kurdish-yoda/TOS/PCB/README.md

# TonsOfSteppers

Stepper Driver Board


## Description
This is an stepper driver board that can drive up to 15 steppers simultaneously,
and up to 8 synchronously. A raspberry is used to control everything. 

## Features
- 8V to 40V input with protection
- 15x stepper pinout.
- Up to 10A capability. 

## Software
All software is written in python. To be used with an RasperryPi with a standart 40pin GPIO.

## Pictures
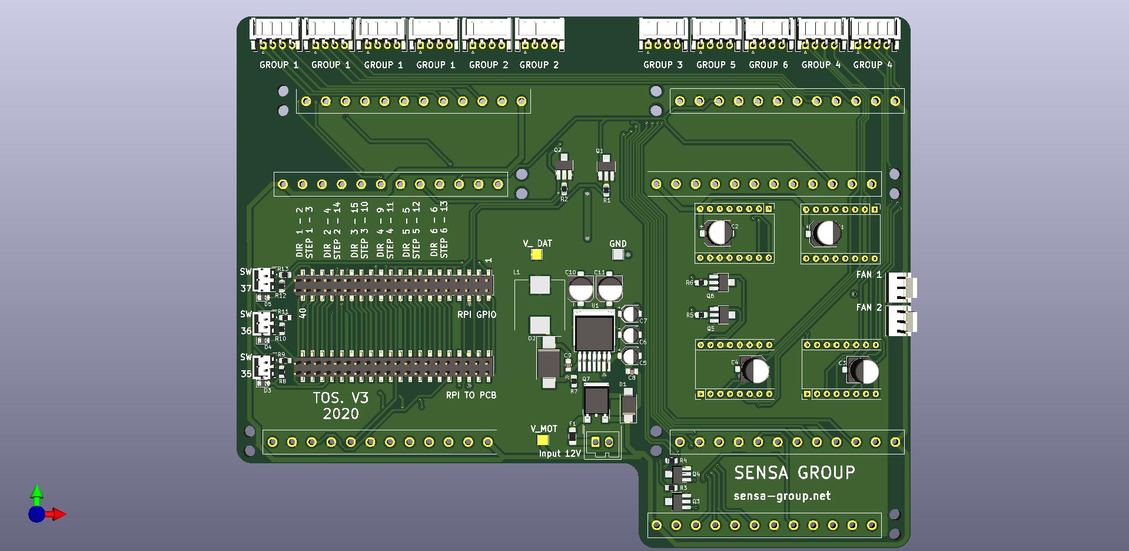
[picture p1: Images/TonOfSteppers.jpg]
Top_view

Bottom_view
