kurdish-yoda/TOS/Code_and_Documents/price.png

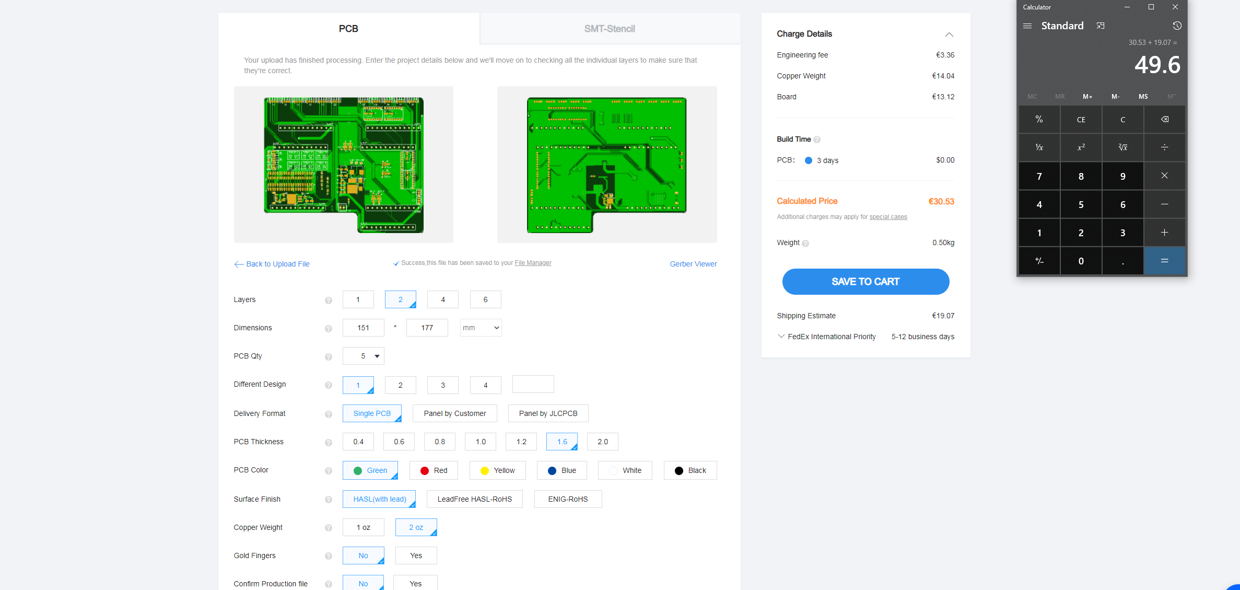
Code_and_Documents/price.png
