kurdish-yoda/TOS/Images/case1.jpeg

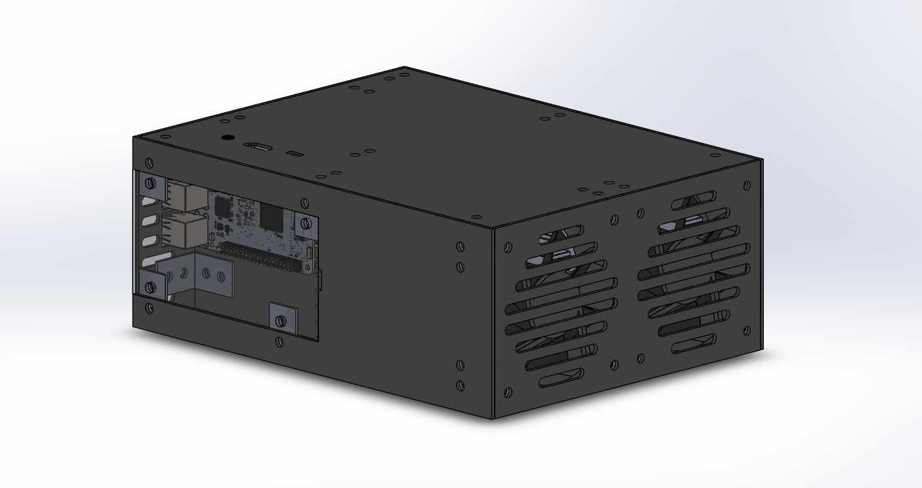
Images/case1.jpeg
