kurdish-yoda/TOS/Code_and_Documents/BOM.xlsx

Electronic Component | Manufacture | Pieces | Footprint Asignment | Datasheet
95157-440LF | AMPHENOL ICC | 4 | J1, J2 | https://export.farnell.com/amphenol-icc/95157-440lf/board-to-board-header-40-position/dp/1924218
LM2678SX-5.0/NOPB | Texas Instruments | 2 | U1 | https://www.ti.com/lit/ds/symlink/lm2678.pdf?HQS=dis-dk-null-digikeymode-dsf-pf-null-wwe&ts=1613410963551
Lestvica 8 pin - Zenski (2.54) | // | 16 | A1, A2, A3, A4 | //
CAP EL 100UF | Würth Elektronik | 8 | C1, C2, C3, C4 | https://www.we-online.de/katalog/datasheet/865230345005.pdf
CAP EL 15UF | Würth Elektronik | 6 | C5, C6, C7 | https://www.mouser.com/datasheet/2/445/865080340002-1726603.pdf
CAP 0.47UF | AVX Corporation | 2 | C8 | http://datasheets.avx.com/X7RDielectric.pdf
CAP 0.01UF | Murata Electronics | 2 | C9 | //
CAP EL 180UF | Panasonic | 4 | C10, C11 | https://www.mouser.com/datasheet/2/315/ABA0000C1251-1138508.pdf
CZRB5343B-HF | Comchip Technology | 2 | D1 | https://eu.mouser.com/datasheet/2/80/CZRB5338B-HF_Thru174956._CZRB5388B-HF_RevA-1481441.pdf
B560CQ-13-F | Diodes Incorporated | 2 | D2 | https://www.diodes.com/assets/Datasheets/B520CQ-B560CQ.pdf
SMD DIODE 0805 | // | 6 | D3, D4, D5 | //
TR/3216FF30-R | Bussmann / Eaton | 2 | F1 | https://www.mouser.com/datasheet/2/87/eaton-3216ff-surface-mount-fuse-data-sheet-1608666.pdf
S4B-XH-A(LF)(SN) | JST Sales America Inc. | 22 | G1, G2, G3, …, G10, G11 | https://www.jst-mfg.com/product/pdf/eng/eXH.pdf
10081121 | Molex | 14 | J3, J4, …, J9 | https://www.molex.com/pdm_docs/ps/PS-99020-0087-001.pdf
53253-0370 | Molex | 4 | J10, J31 | https://www.mouser.com/datasheet/2/276/0532530370_PCB_HEADERS-170958.pdf
B2B-PH-K-S(LF)(SN) | JST Sales America Inc. | 6 | J11, J12, J13 | https://www.jst-mfg.com/product/pdf/eng/ePH.pdf
1984617 | Phoenix Contact | 2 | J33 | https://media.digikey.com/pdf/Data%20Sheets/Phoenix%20Contact%20PDFs/Combicon%20Compact%20Series.pdf
7443551221 | Würth Elektronik | 2 | L1 | https://www.mouser.com/datasheet/2/445/7443551221-1721653.pdf
2STF1360 | STMicroelectronics | 12 | Q1, Q2, Q3, Q4, Q5, Q6 | https://www.st.com/content/ccc/resource/technical/document/datasheet/f9/7c/12/94/01/da/41/03/CD00073146.pdf/files/CD00073146.pdf/jcr:content/translations/en.C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
ATP106-TL-H | ON Semiconductor | 2 | Q7 | https://www.onsemi.com/pub/Collateral/ENA1597-D.PDF
RES 1K 0805 | // | 18 | R1, ..., R6, R8, R10, R12 | //
RES 10K 0805 | // | 8 | R7, R9, R11, R13 | //
USB-A-S-RA-TSMT | MULTICOMP | 5 | // | http://www.farnell.com/datasheets/1864222.pdf
KONEKTOR DIN 41651 40 PINA KABL. | CONNFLY electronic | 10 | // | https://www.mgelectronic.rs/konektor-din-41651-40-pina-kabldr%C5%BEa%C4%8D
7805 SMD | Texas Instruments | 2 | // | https://export.farnell.com/texas-instruments/ua7805ckttr/voltage-regulator-fixed-5v-to/dp/3122753?st=7805
