kurdish-yoda/TOS/Code_and_Documents/John Mastercode/Hc595_Solenoid_Driver.pdf

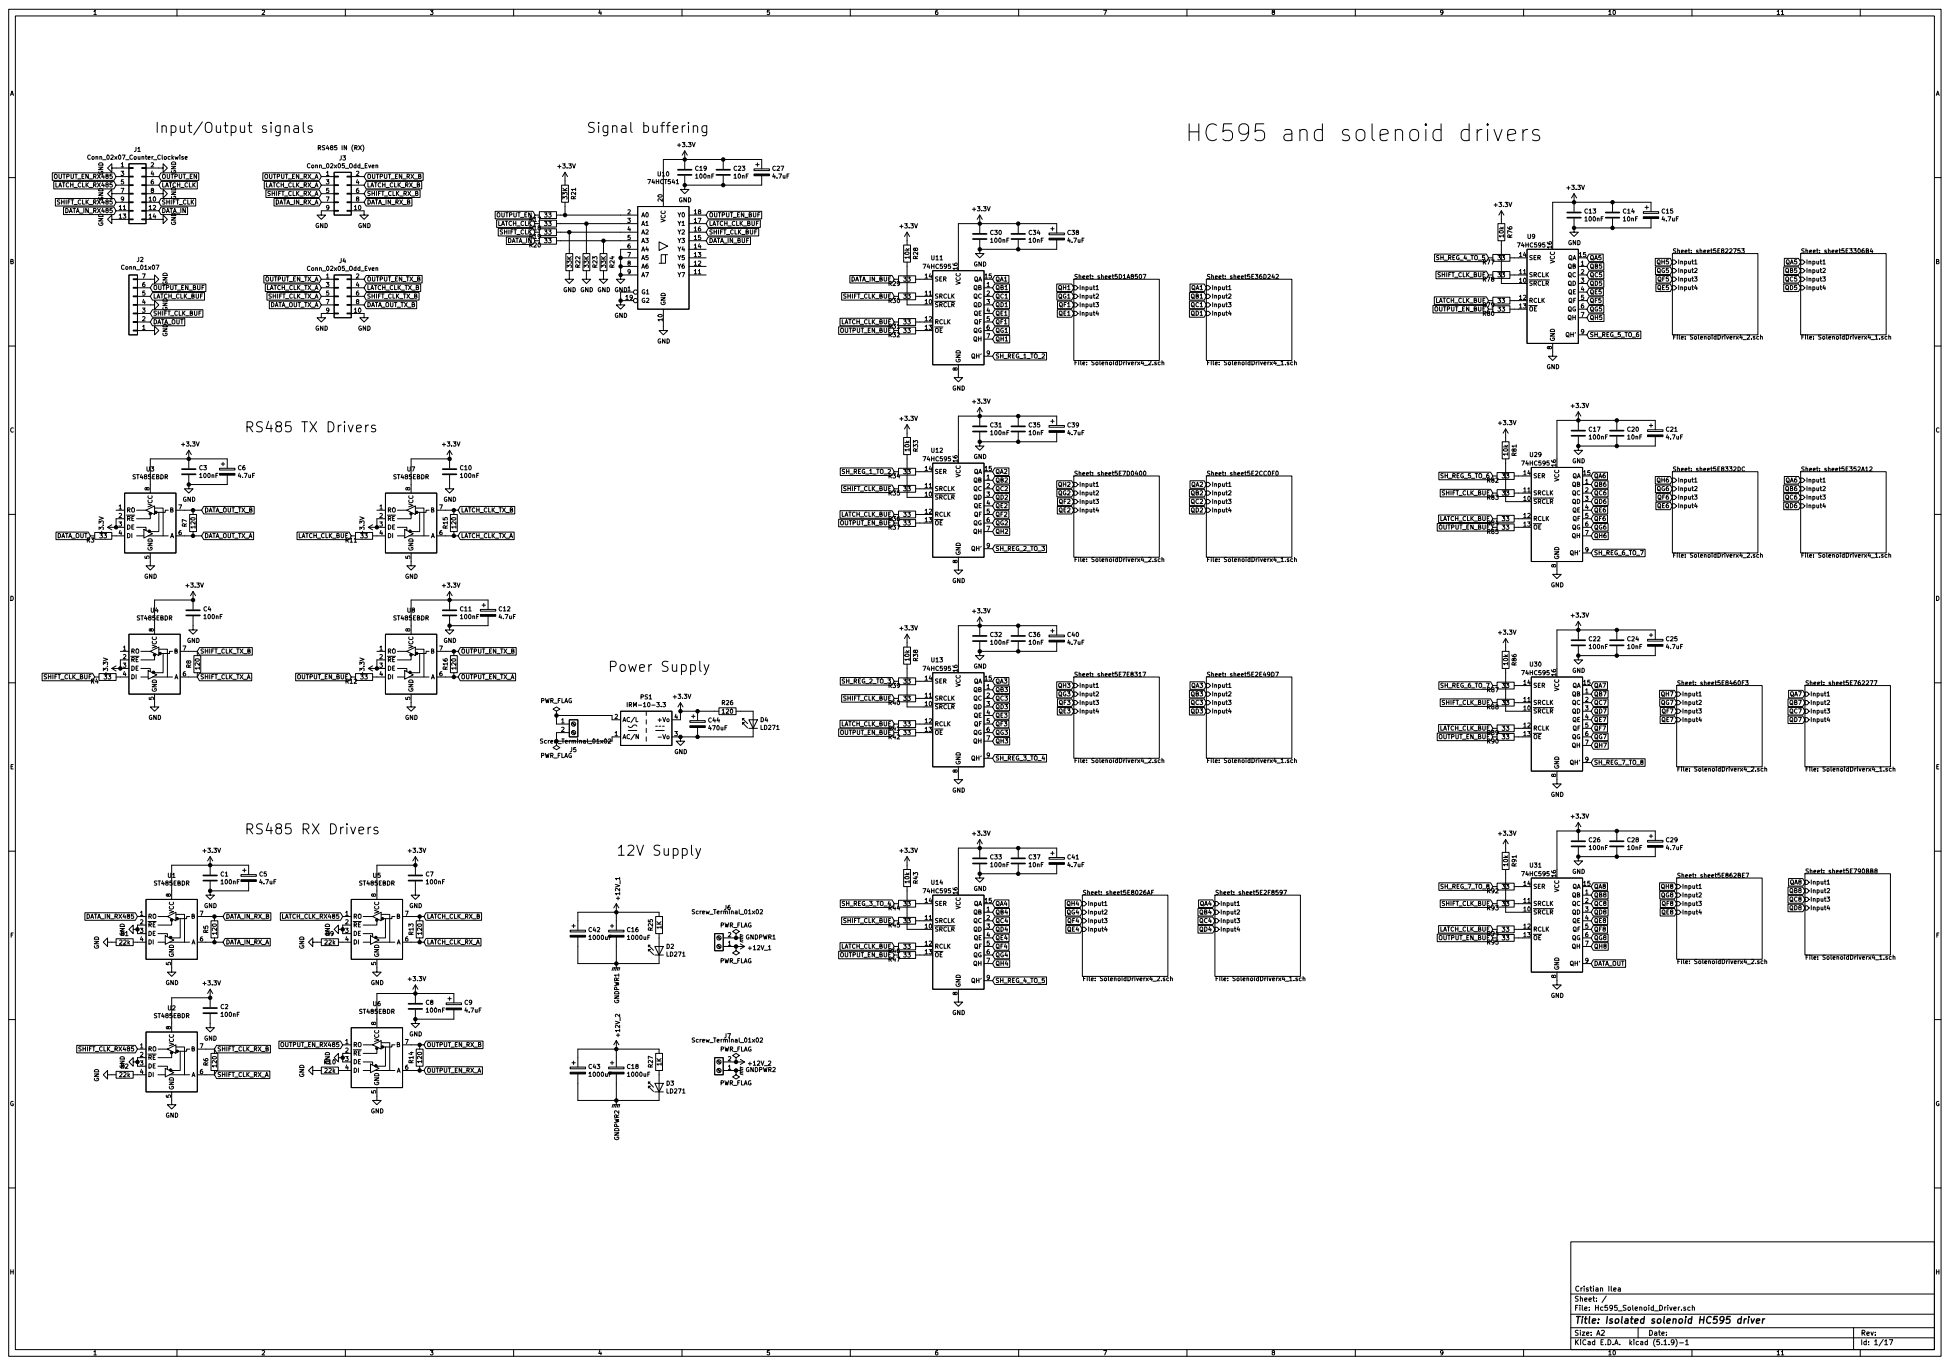
[picture p8: page 1]

8 U8 ST485EBDR R15 120 GND R7 120 RO 1 RE 2 DE 3 DI 4 GND

File: Hc595_Solenoid_Driver.sch Sheet: / Cristian Ilea

Id: 1/17 Title: Isolated solenoid HC595 driver

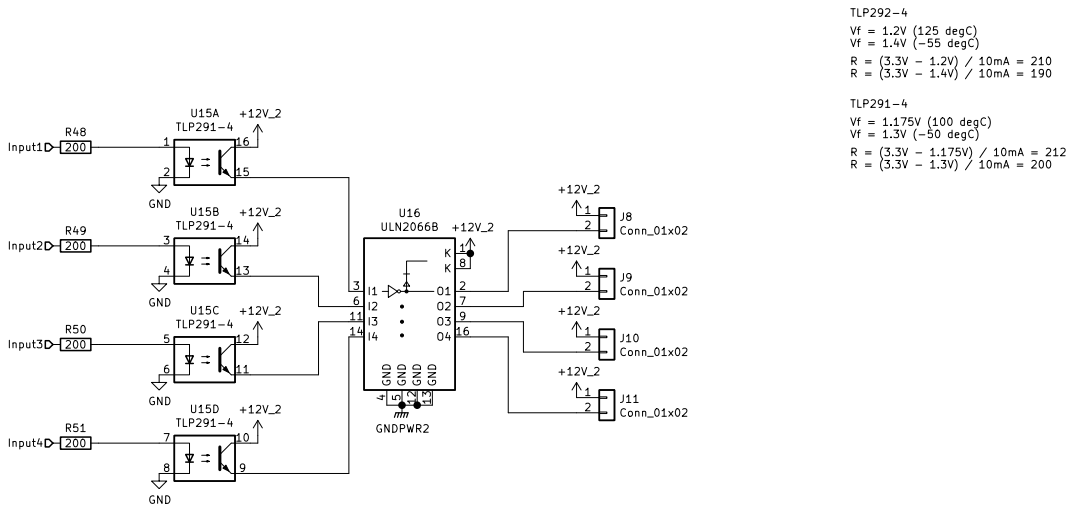
[picture p9: page 2]

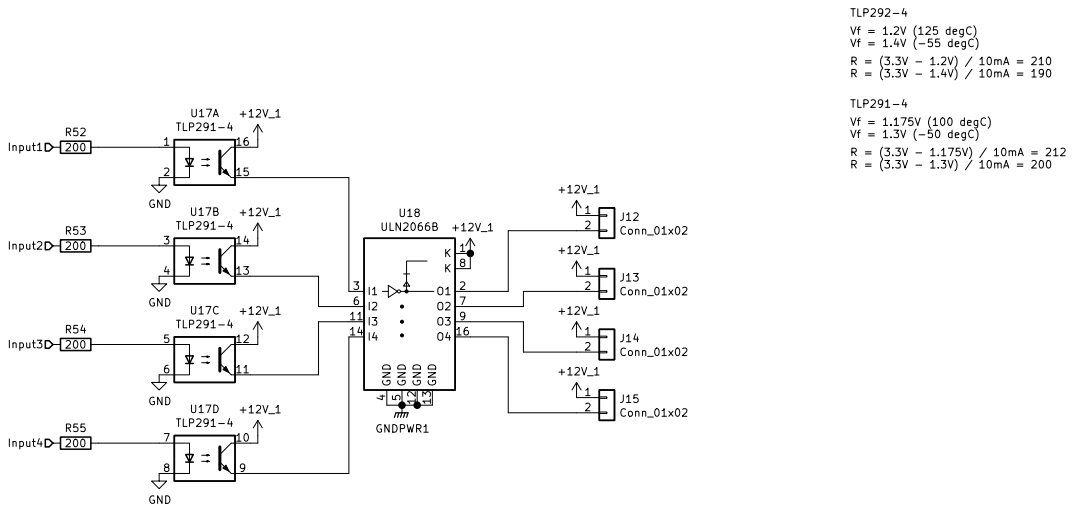
[picture p10: page 3]

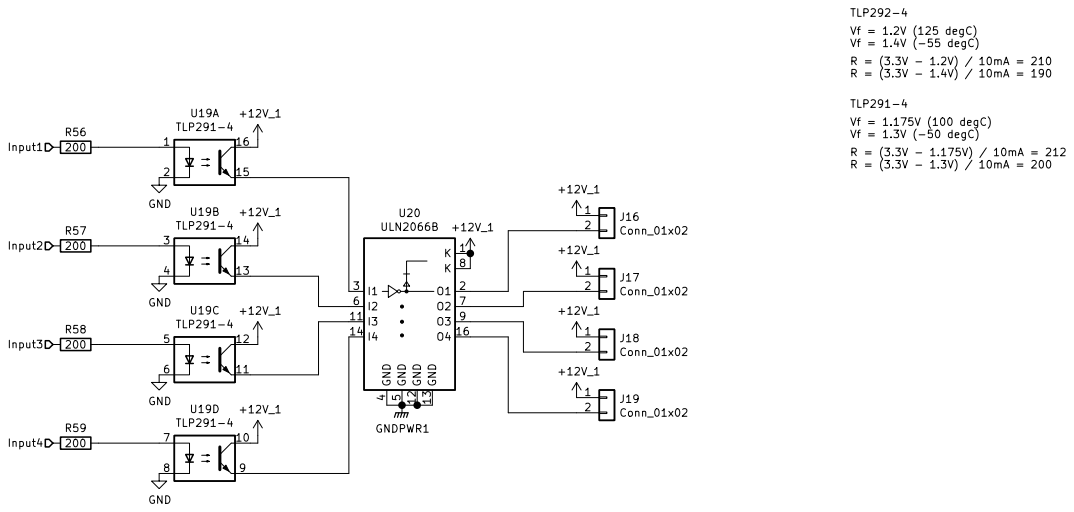
[picture p11: page 4]

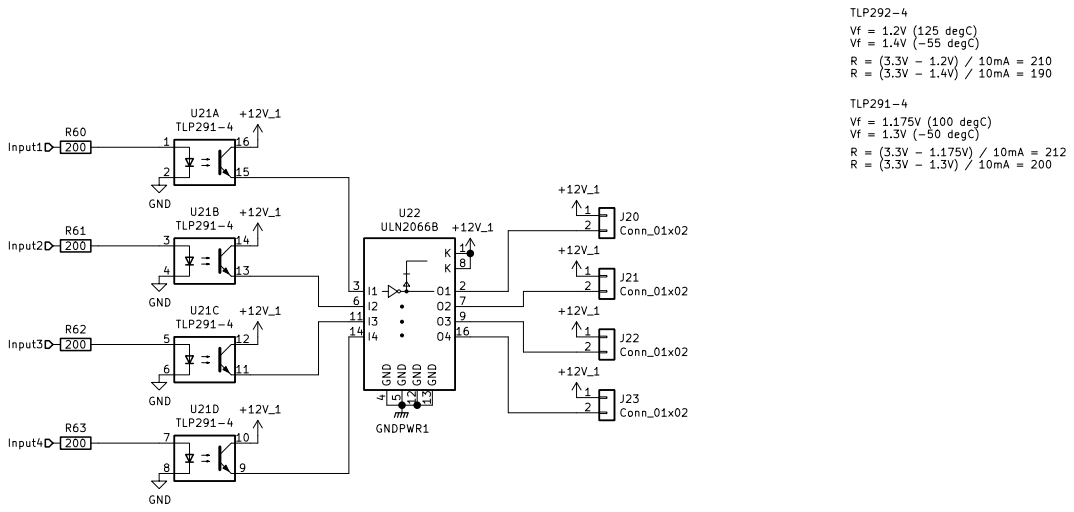
[picture p12: page 5]

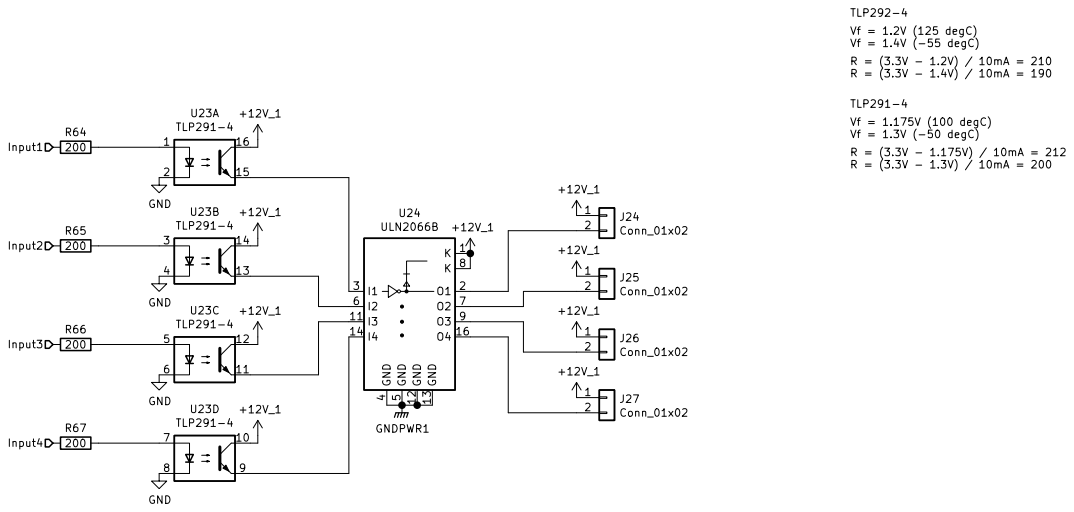
[picture p13: page 6]

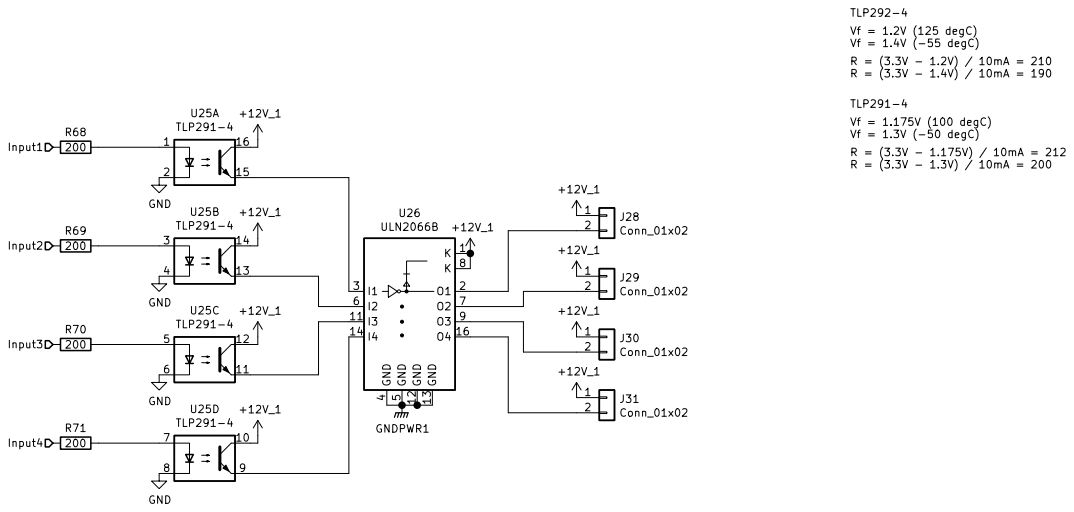
[picture p14: page 7]

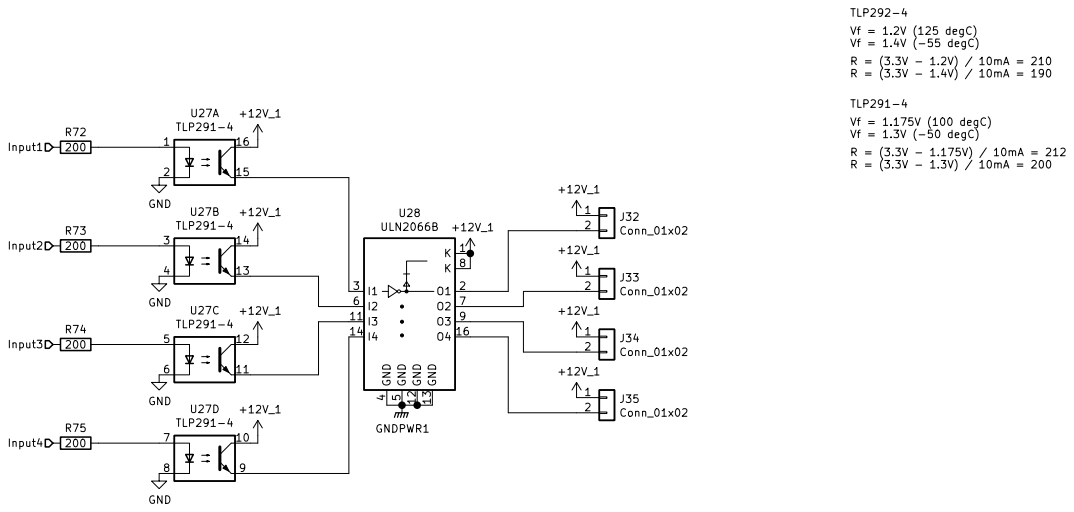
[picture p15: page 8]

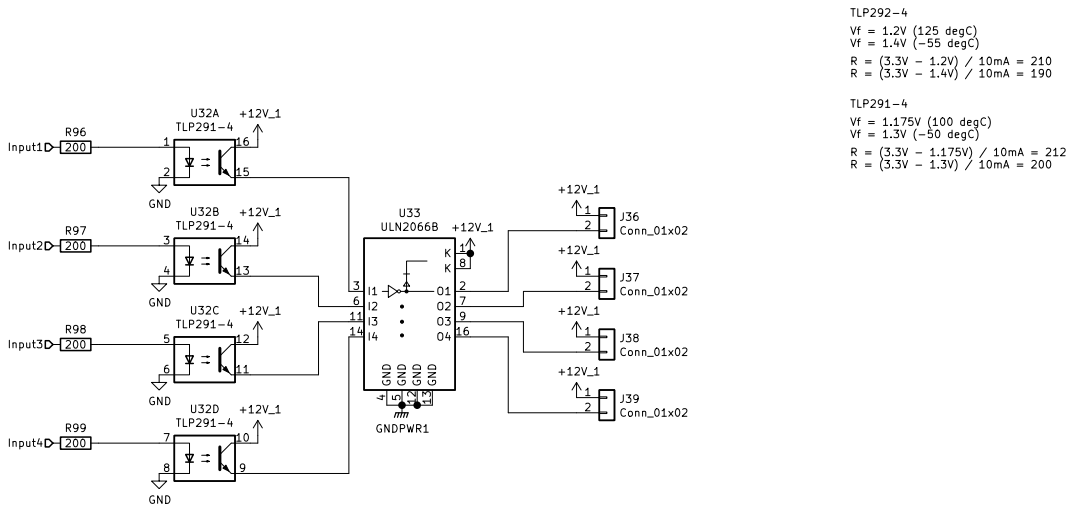
[picture p16: page 9]

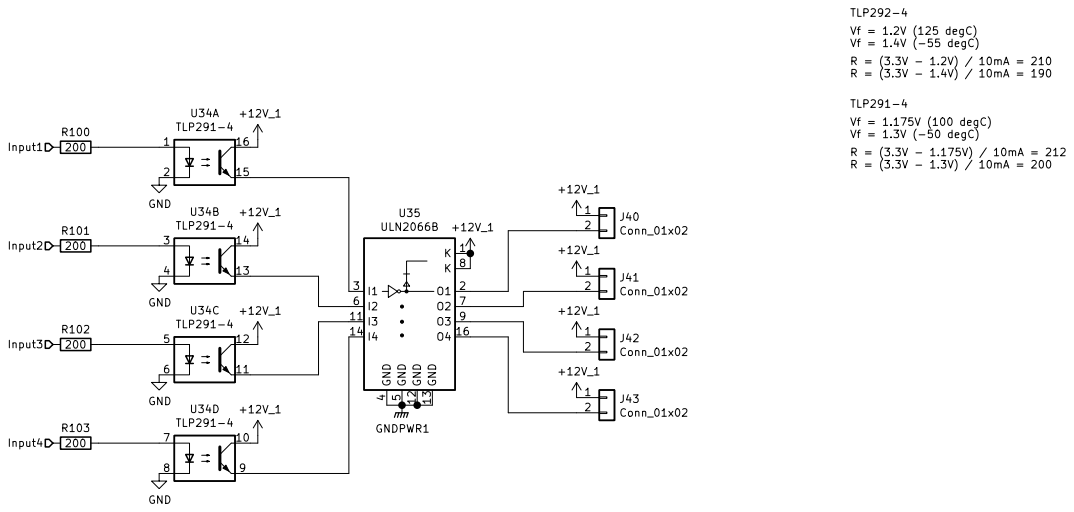
[picture p17: page 10]

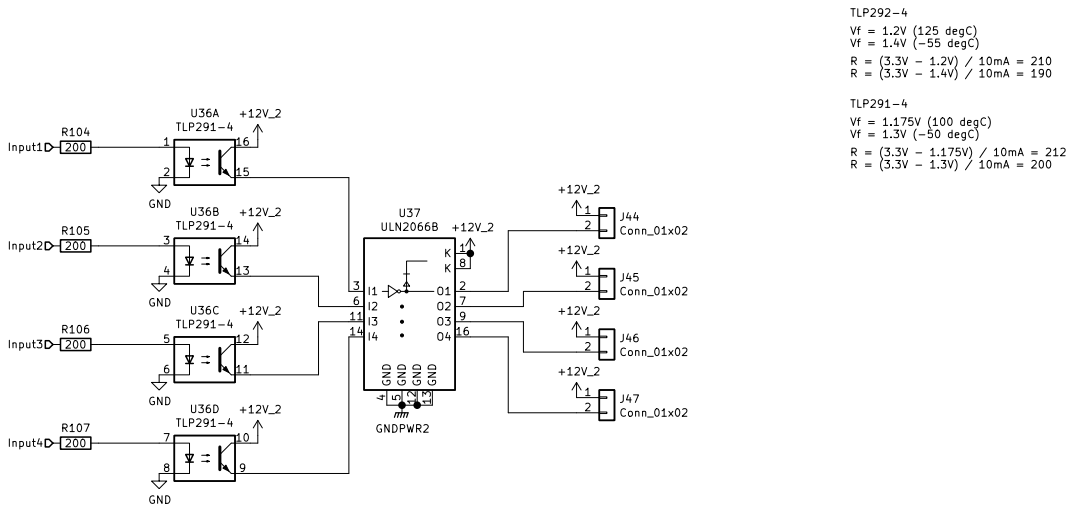
[picture p18: page 11]

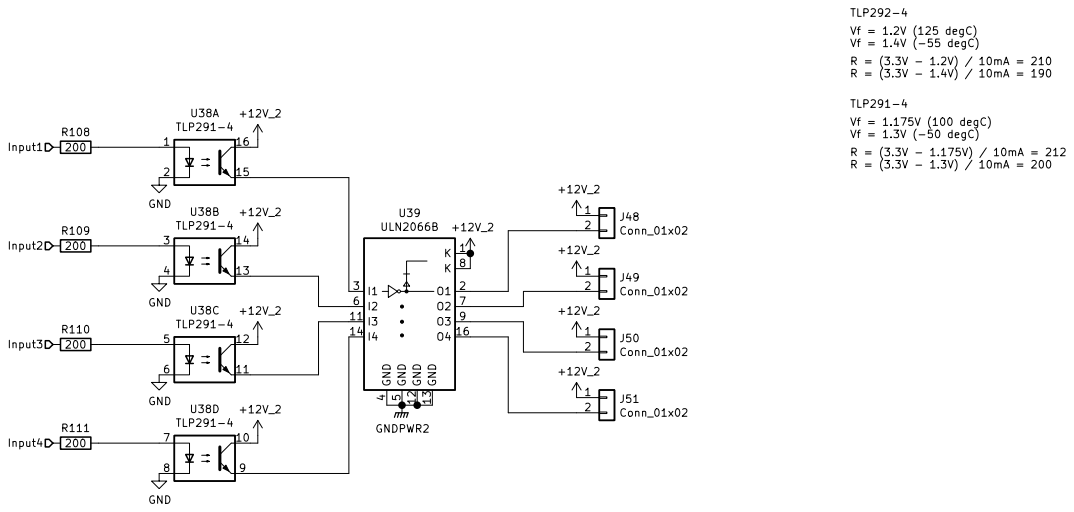
[picture p19: page 12]

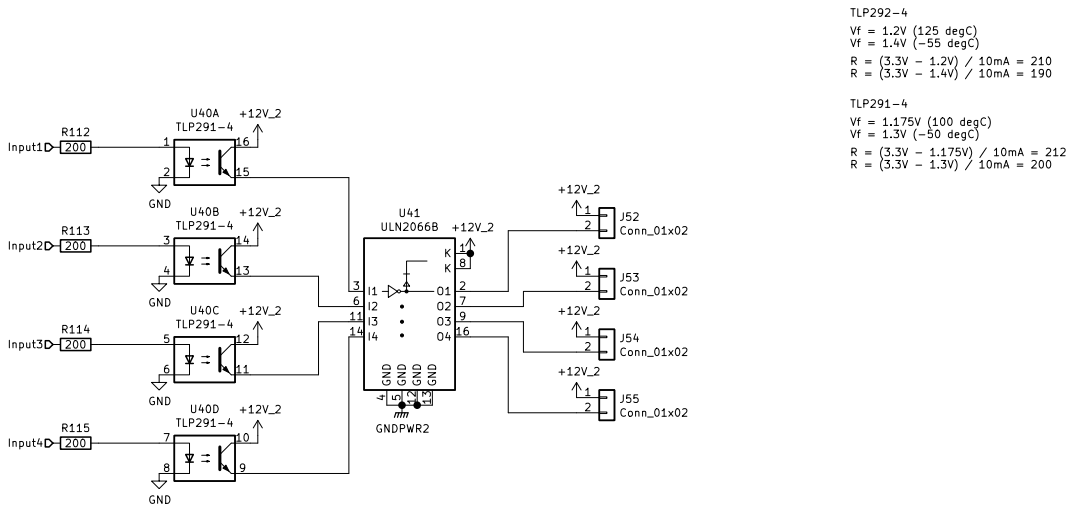
[picture p20: page 13]

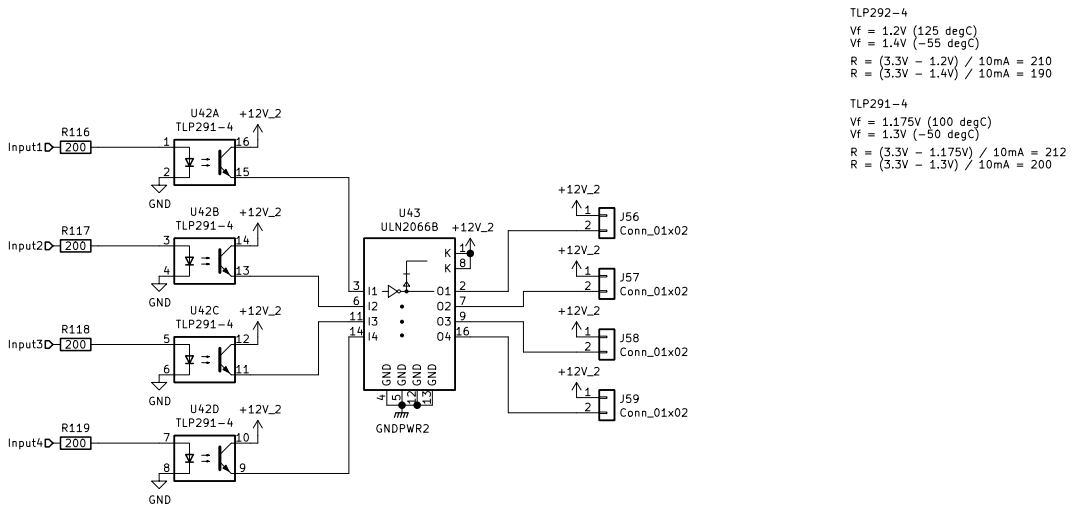
[picture p21: page 14]

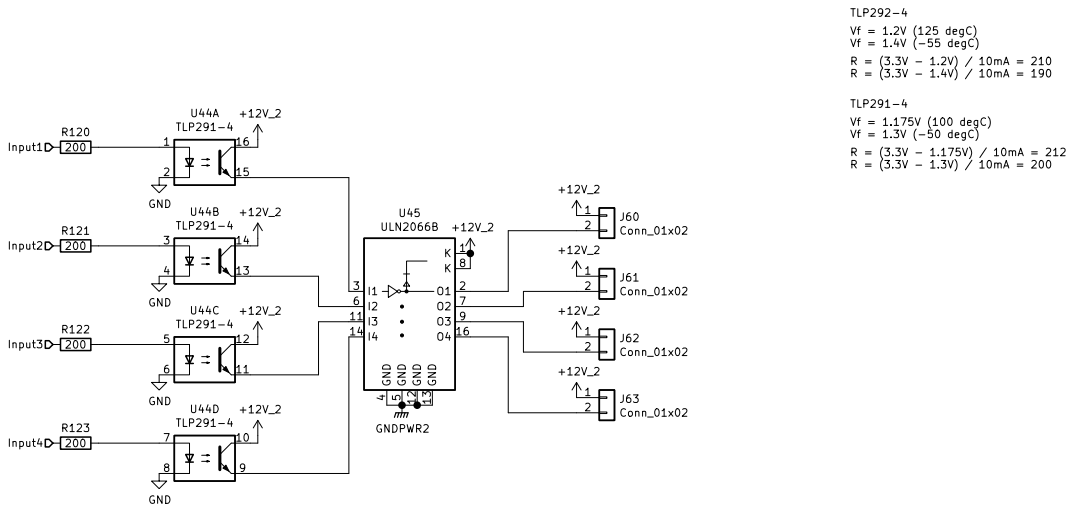
[picture p22: page 15]

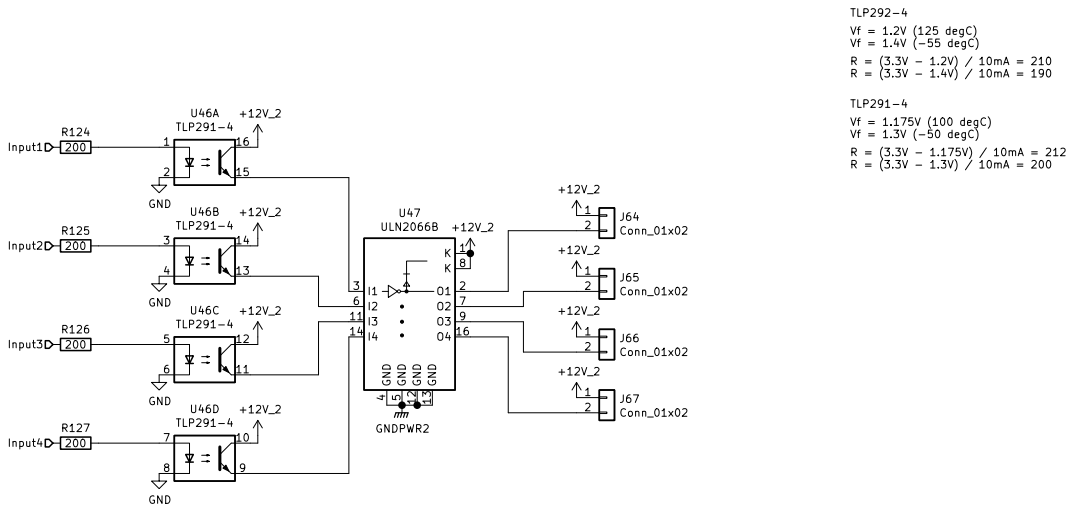
[picture p23: page 16]

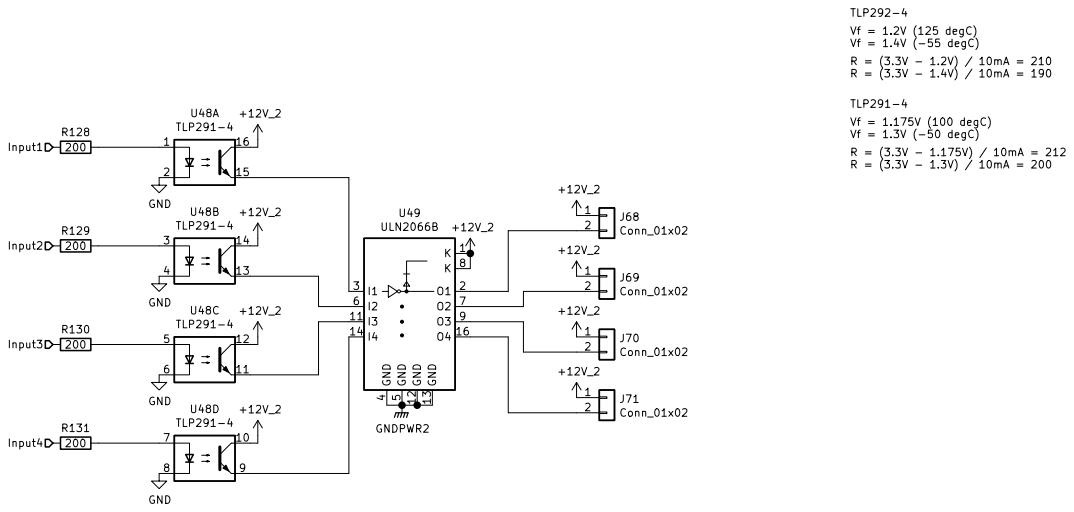
[picture p24: page 17]
