kurdish-yoda/TOS/Code_and_Documents/John Mastercode/Hc595_Solenoid_Driver/Hc595_Solenoid_Driver.kicad_pcb

## KiCad design Code_and_Documents/John Mastercode/Hc595_Solenoid_Driver/Hc595_Solenoid_Driver.kicad_pcb (2021-12-25)

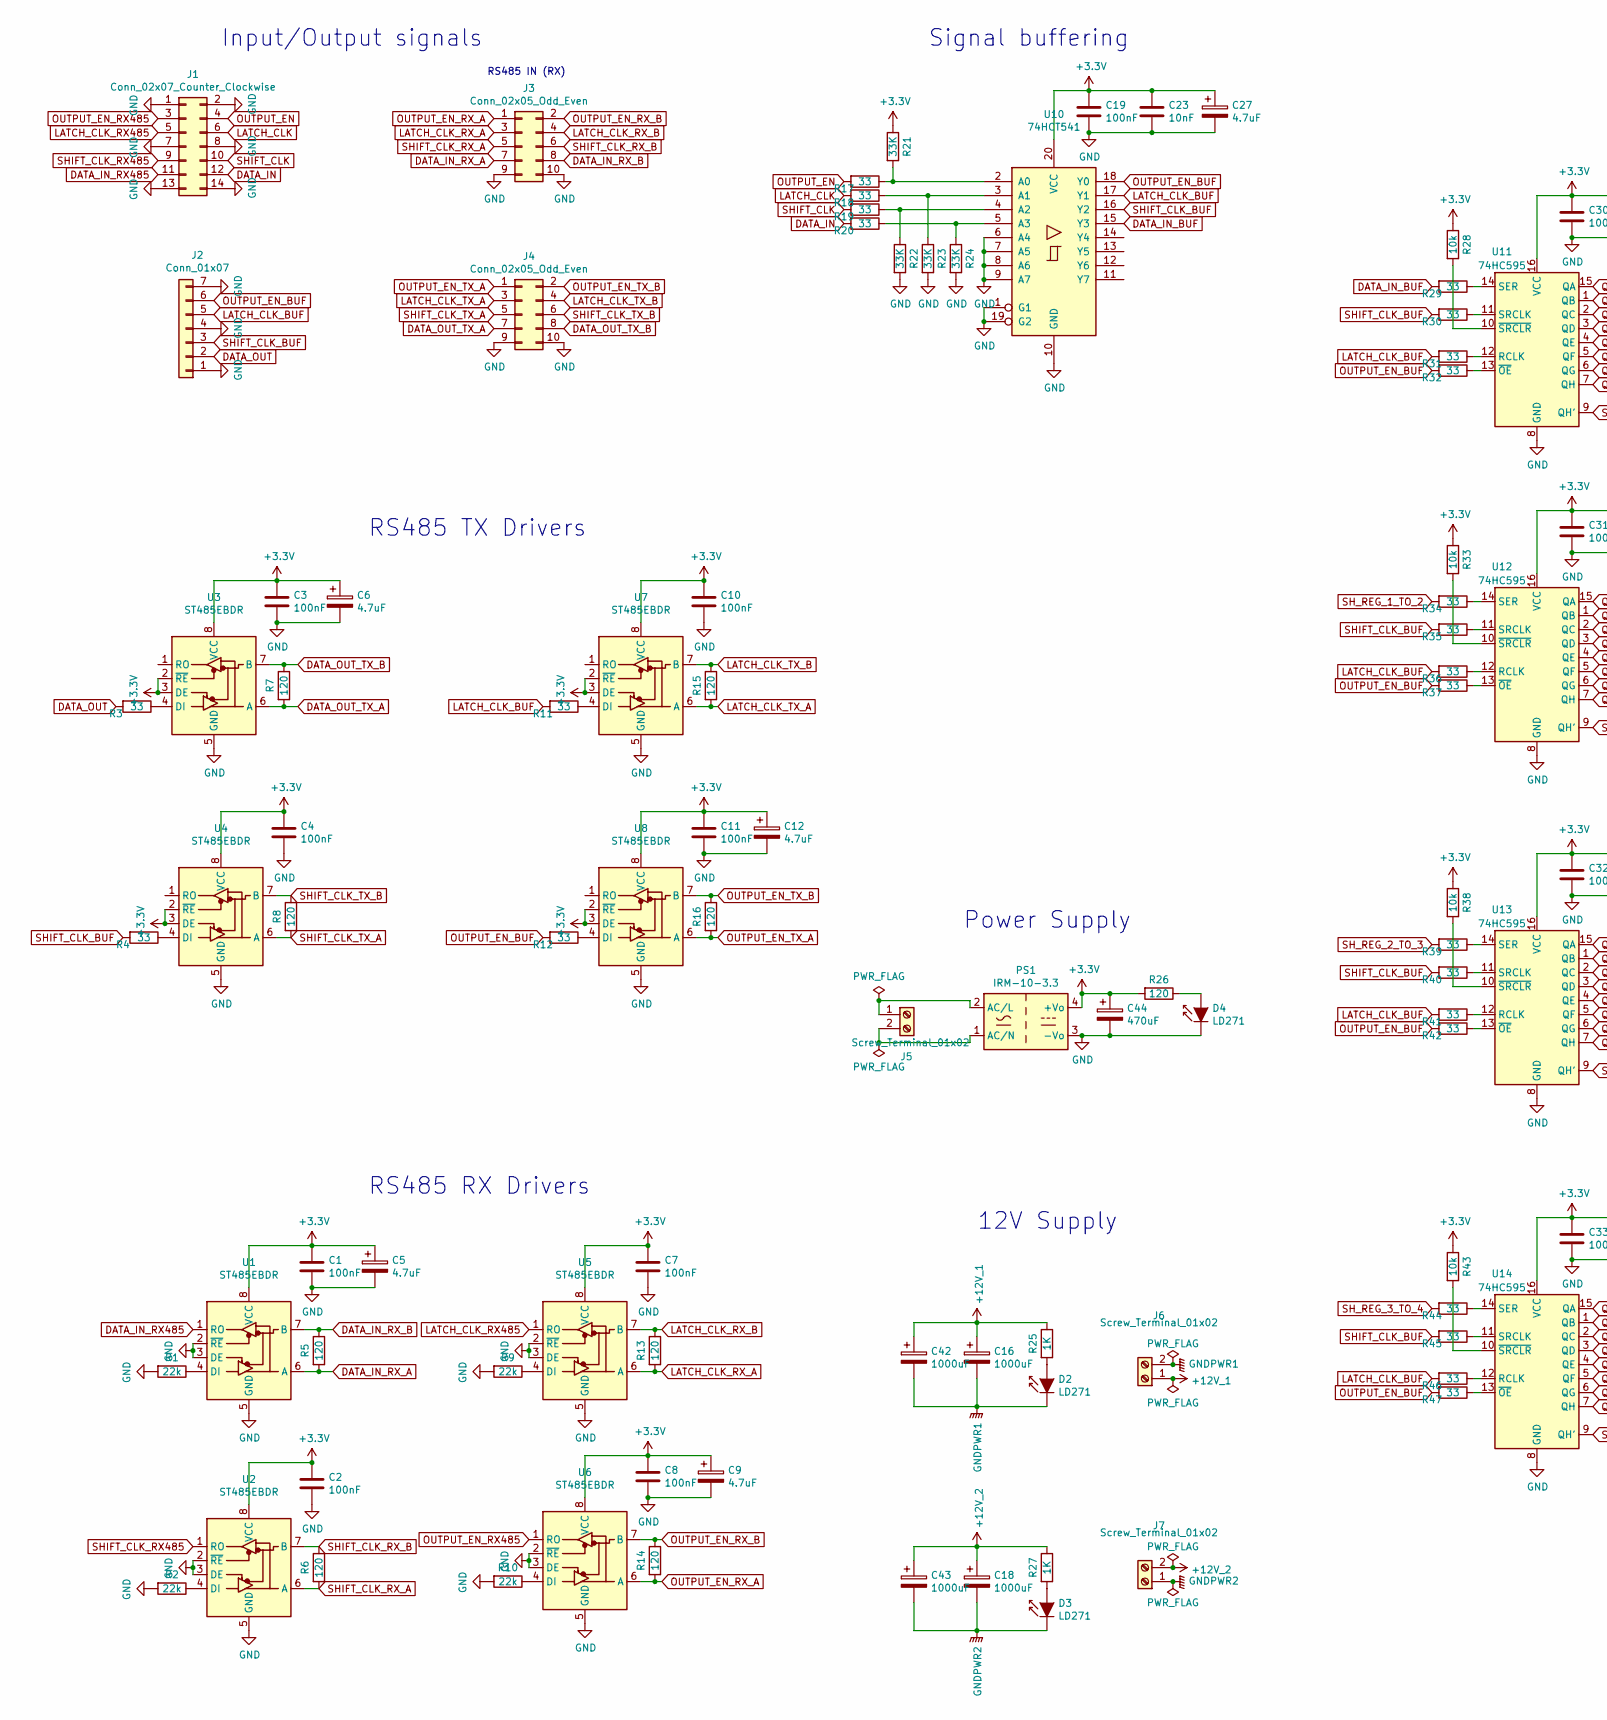
[picture p25: schematic Hc595_Solenoid_Driver.sch, Isolated solenoid HC595 driver, part in row 1, column 1]

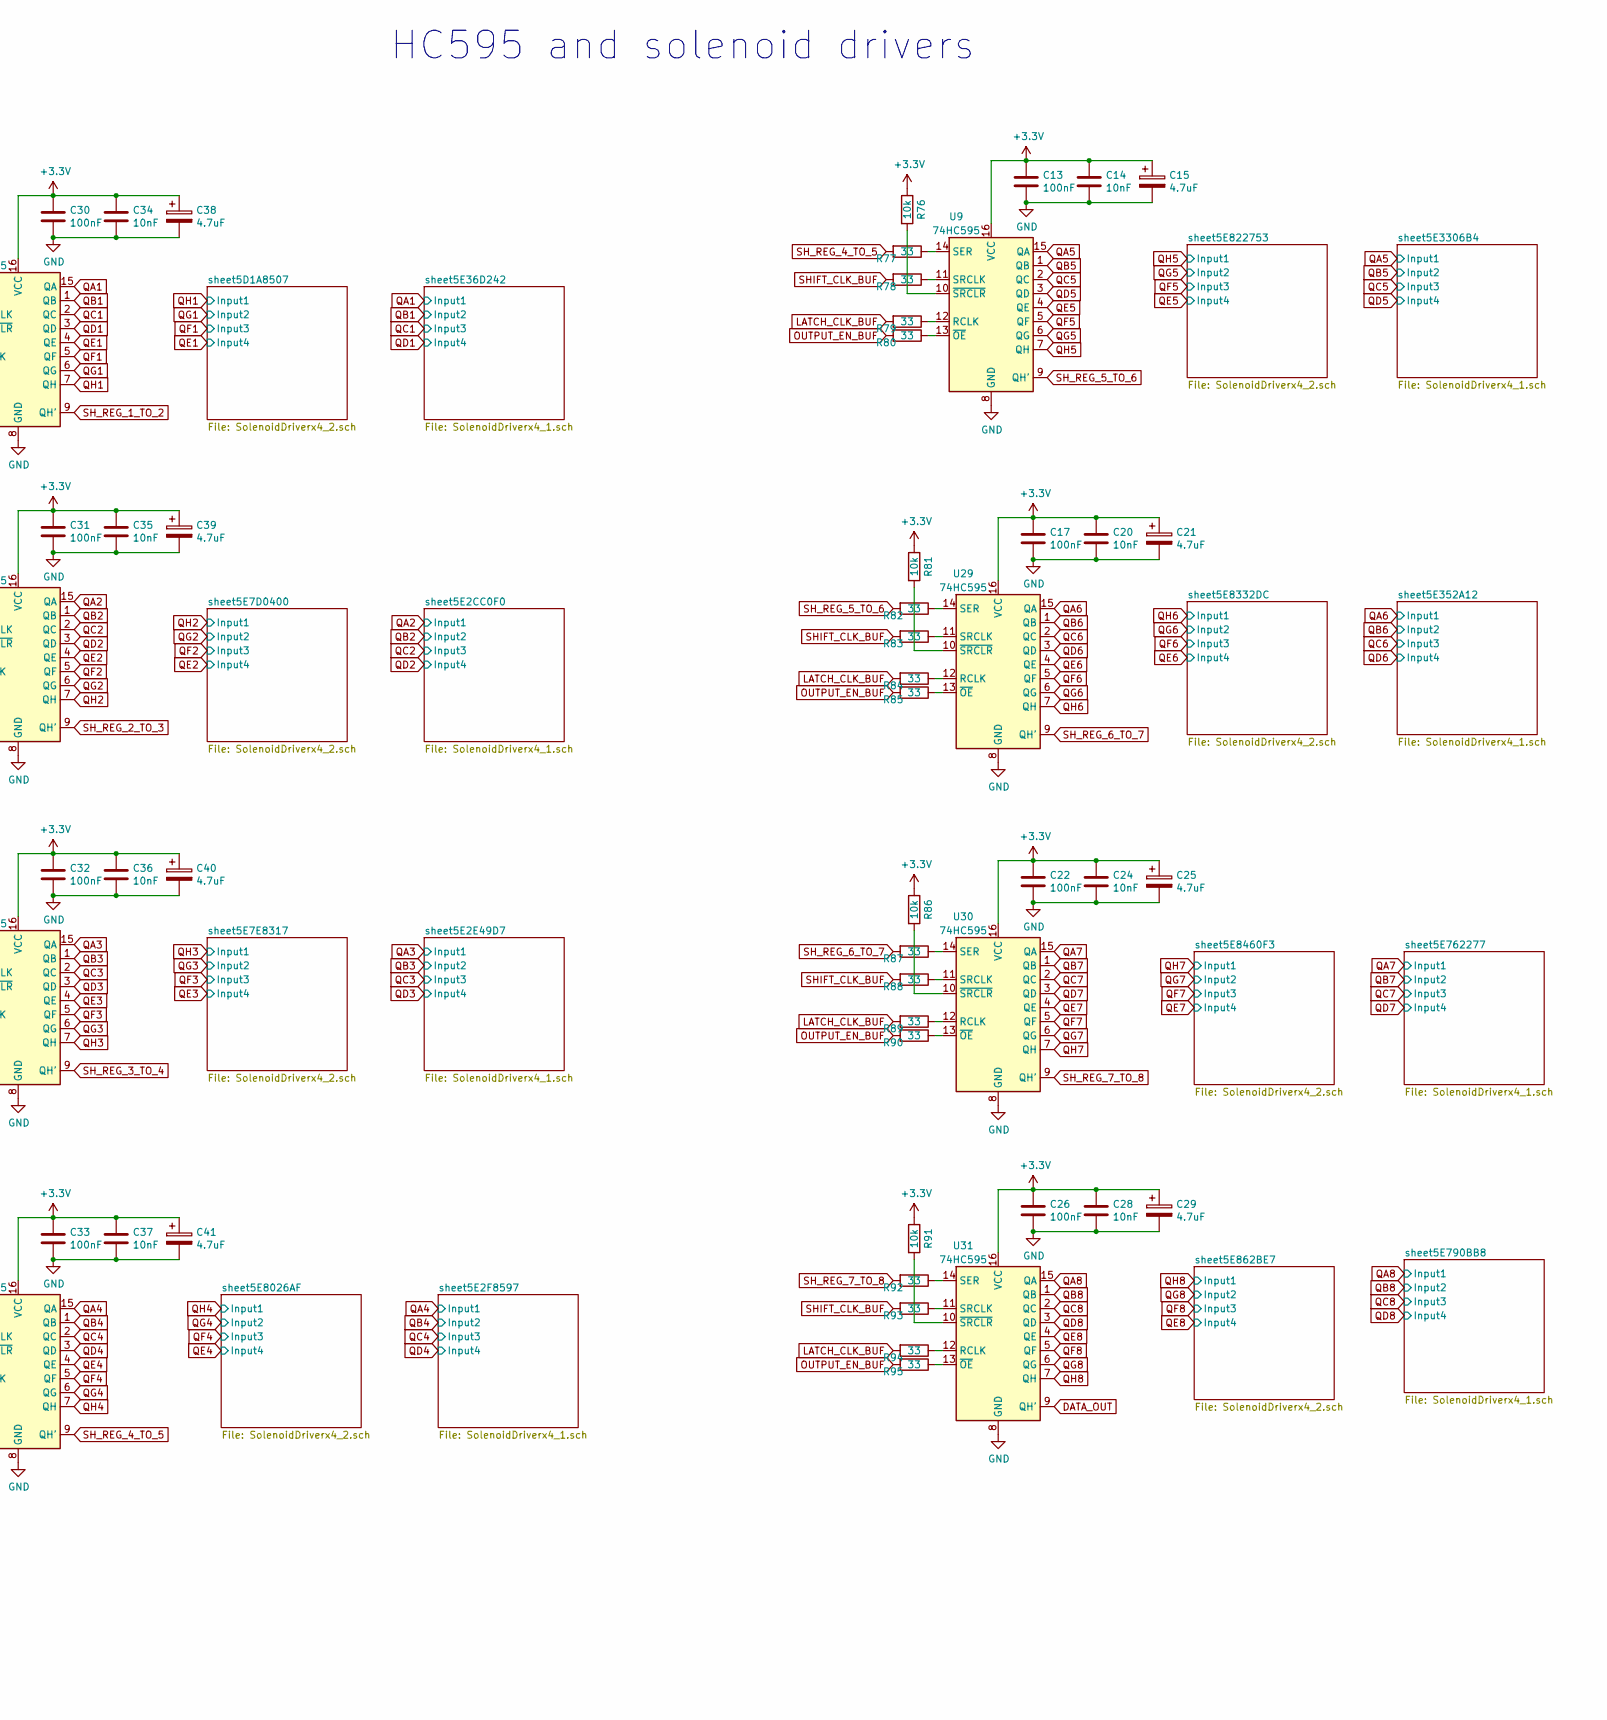
[picture p26: schematic Hc595_Solenoid_Driver.sch, Isolated solenoid HC595 driver, part in row 1, column 2]

Parts:
C1, C2, C3, C4, C7, C8, C10, C11, C13, C17, C19, C22, C26, C30, C31, C32, C33: 100nF; C_0805_2012Metric_ValInMiddleFABlayer
C5, C6, C9, C12, C15, C21, C25, C27, C29, C38, C39, C40, C41: 4.7uF; D_SMA_SMA_Capacitor
C14, C20, C23, C24, C28, C34, C35, C36, C37: 10nF; C_0805_2012Metric_ValInMiddleFABlayer
C16, C18, C42, C43: 1000uF; CP_Radial_D12.5mm_P5.00mm
C44: 470uF; CP_Elec_8x5.4_ModifFABlayer
D2, D3, D4: LD271; LED_D5.0mm_IRGrey
J1: Conn_02x07_Counter_Clockwise; PinHeader_2x07_P2.54mm_Vertical_ModifFABlayer
J2: Conn_01x07; PinHeader_1x07_P2.54mm_Vertical
J3, J4: Conn_02x05_Odd_Even; IDC-Header_2x05_P2.54mm_Vertical_ModifFABlayer
J5, J6, J7: Screw_Terminal_01x02; TerminalBlock_bornier-2_P5.08mm
PS1: IRM-10-3.3; Converter_ACDC_MeanWell_IRM-10-xx_THT
R1, R2, R9, R10: 22k; R_0603_1608Metric_ValInMiddleFABlayer
R3, R4, R11, R12, R17, R18, R19, R20, R29, R30, R31, R32, R34, R35, R36, R37, R39, R40, R41, R42, R44, R45, R46, R47, R77, R78, R79, R80, R82, R83, R84, R85, R87, R88, R89, R90, R92, R93, R94, R95: 33; R_0603_1608Metric_ValInMiddleFABlayer
R5, R6, R7, R8, R13, R14, R15, R16, R26: 120; R_0603_1608Metric_ValInMiddleFABlayer
R21, R22, R23, R24: 33K; R_0603_1608Metric_ValInMiddleFABlayer
R25, R27: 1K; R_0603_1608Metric_ValInMiddleFABlayer
R28, R33, R38, R43, R76, R81, R86, R91: 10k; R_0603_1608Metric_ValInMiddleFABlayer
U1, U2, U3, U4, U5, U6, U7, U8: ST485EBDR; SOIC-8_3.9x4.9mm_P1.27mm_ModifFABlayer
U9, U11, U12, U13, U14, U29, U30, U31: 74HC595; SOIC-16_3.9x9.9mm_P1.27mm
U10: 74HCT541; SO-20_12.8x7.5mm_P1.27mm

Connections:
+3V3: C1.1, C2.1, C3.1, C4.1, C5.1, C6.1, C7.1, C8.1, C9.1, C10.1, C11.1, C12.1, C13.1, C14.1, C15.1, C17.1, C19.1, C20.1, C21.1, C22.1, C23.1, C24.1, C25.1, C26.1, C27.1, C28.1, C29.1, C30.1, C31.1, C32.1, C33.1, C34.1, C35.1, C36.1, C37.1, C38.1, C39.1, C40.1, C41.1, C44.1, PS1.4 (+Vo), R21.1, R26.2, R28.1, R33.1, R38.1, R43.1, R76.1, R81.1, R86.1, R91.1, U1.8 (VCC), U2.8 (VCC), U3.2 (~RE), U3.3 (DE), U3.8 (VCC), U4.2 (~RE), U4.3 (DE), U4.8 (VCC), U5.8 (VCC), U6.8 (VCC), U7.2 (~RE), U7.3 (DE), U7.8 (VCC), U8.2 (~RE), U8.3 (DE), U8.8 (VCC), U9.16 (VCC), U10.20 (VCC), U11.16 (VCC), U12.16 (VCC), U13.16 (VCC), U14.16 (VCC), U29.16 (VCC), U30.16 (VCC), U31.16 (VCC)
+12V_1: C16.1, C42.1, J6.1, R25.1; also elsewhere on the board
+12V_2: C18.1, C43.1, J7.2, R27.1; also elsewhere on the board
DATA_IN: J1.12, R20.2
DATA_IN_BUF: R29.2, U10.15 (Y3)
DATA_IN_RX485: J1.11, U1.1 (RO)
DATA_IN_RX_A: J3.7, R5.2, U1.6 (A)
DATA_IN_RX_B: J3.8, R5.1, U1.7 (B)
DATA_OUT: J2.2, R3.2, U31.9 (QH')
DATA_OUT_TX_A: J4.7, R7.2, U3.6 (A)
DATA_OUT_TX_B: J4.8, R7.1, U3.7 (B)
GND: C1.2, C2.2, C3.2, C4.2, C5.2, C6.2, C7.2, C8.2, C9.2, C10.2, C11.2, C12.2, C13.2, C14.2, C15.2, C17.2, C19.2, C20.2, C21.2, C22.2, C23.2, C24.2, C25.2, C26.2, C27.2, C28.2, C29.2, C30.2, C31.2, C32.2, C33.2, C34.2, C35.2, C36.2, C37.2, C38.2, C39.2, C40.2, C41.2, C44.2, D4.1 (K), J1.1, J1.2, J1.7, J1.8, J1.13, J1.14, J2.1, J2.4, J2.7, J3.9, J3.10, J4.9, J4.10, PS1.3 (-Vo), R1.2, R2.2, R9.2, R10.2, R22.2, R23.2, R24.2, U1.2 (~RE), U1.3 (DE), U1.5 (GND), U2.2 (~RE), U2.3 (DE), U2.5 (GND), U3.5 (GND), U4.5 (GND), U5.2 (~RE), U5.3 (DE), U5.5 (GND), U6.2 (~RE), U6.3 (DE), U6.5 (GND), U7.5 (GND), U8.5 (GND), U9.8 (GND), U10.1 (G1), U10.6 (A4), U10.7 (A5), U10.8 (A6), U10.9 (A7), U10.10 (GND), U10.19 (G2), U11.8 (GND), U12.8 (GND), U13.8 (GND), U14.8 (GND), U29.8 (GND), U30.8 (GND), U31.8 (GND); also elsewhere on the board
GNDPWR1: C16.2, C42.2, D2.1 (K), J6.2; also elsewhere on the board
GNDPWR2: C18.2, C43.2, D3.1 (K), J7.1; also elsewhere on the board
LATCH_CLK: J1.6, R18.2
LATCH_CLK_BUF: J2.5, R11.2, R31.2, R36.2, R41.2, R46.2, R79.2, R84.2, R89.2, R94.2, U10.17 (Y1)
LATCH_CLK_RX485: J1.5, U5.1 (RO)
LATCH_CLK_RX_A: J3.3, R13.2, U5.6 (A)
LATCH_CLK_RX_B: J3.4, R13.1, U5.7 (B)
LATCH_CLK_TX_A: J4.3, R15.2, U7.6 (A)
LATCH_CLK_TX_B: J4.4, R15.1, U7.7 (B)
unnamed: D2.2 (A), R25.2
unnamed: D3.2 (A), R27.2
unnamed: D4.2 (A), R26.1
unnamed: J5.1, PS1.2 (AC/L)
unnamed: J5.2, PS1.1 (AC/N)
unnamed: R1.1, U1.4 (DI)
unnamed: R2.1, U2.4 (DI)
unnamed: R3.1, U3.4 (DI)
unnamed: R4.1, U4.4 (DI)
unnamed: R9.1, U5.4 (DI)
unnamed: R10.1, U6.4 (DI)
unnamed: R11.1, U7.4 (DI)
unnamed: R12.1, U8.4 (DI)
unnamed: R17.1, R21.2, U10.2 (A0)
unnamed: R18.1, R23.1, U10.3 (A1)
unnamed: R19.1, R22.1, U10.4 (A2)
unnamed: R20.1, R24.1, U10.5 (A3)
unnamed: R28.2, U11.10 (~SRCLR)
unnamed: R29.1, U11.14 (SER)
unnamed: R30.1, U11.11 (SRCLK)
unnamed: R31.1, U11.12 (RCLK)
unnamed: R32.1, U11.13 (~OE)
unnamed: R33.2, U12.10 (~SRCLR)
unnamed: R34.1, U12.14 (SER)
unnamed: R35.1, U12.11 (SRCLK)
unnamed: R36.1, U12.12 (RCLK)
unnamed: R37.1, U12.13 (~OE)
unnamed: R38.2, U13.10 (~SRCLR)
unnamed: R39.1, U13.14 (SER)
unnamed: R40.1, U13.11 (SRCLK)
unnamed: R41.1, U13.12 (RCLK)
unnamed: R42.1, U13.13 (~OE)
unnamed: R43.2, U14.10 (~SRCLR)
unnamed: R44.1, U14.14 (SER)
unnamed: R45.1, U14.11 (SRCLK)
unnamed: R46.1, U14.12 (RCLK)
unnamed: R47.1, U14.13 (~OE)
unnamed: R76.2, U9.10 (~SRCLR)
unnamed: R77.1, U9.14 (SER)
unnamed: R78.1, U9.11 (SRCLK)
unnamed: R79.1, U9.12 (RCLK)
unnamed: R80.1, U9.13 (~OE)
unnamed: R81.2, U29.10 (~SRCLR)
unnamed: R82.1, U29.14 (SER)
unnamed: R83.1, U29.11 (SRCLK)
unnamed: R84.1, U29.12 (RCLK)
unnamed: R85.1, U29.13 (~OE)
unnamed: R86.2, U30.10 (~SRCLR)
unnamed: R87.1, U30.14 (SER)
unnamed: R88.1, U30.11 (SRCLK)
unnamed: R89.1, U30.12 (RCLK)
unnamed: R90.1, U30.13 (~OE)
unnamed: R91.2, U31.10 (~SRCLR)
unnamed: R92.1, U31.14 (SER)
unnamed: R93.1, U31.11 (SRCLK)
unnamed: R94.1, U31.12 (RCLK)
unnamed: R95.1, U31.13 (~OE)
OUTPUT_EN: J1.4, R17.2
OUTPUT_EN_BUF: J2.6, R12.2, R32.2, R37.2, R42.2, R47.2, R80.2, R85.2, R90.2, R95.2, U10.18 (Y0)
OUTPUT_EN_RX485: J1.3, U6.1 (RO)
OUTPUT_EN_RX_A: J3.1, R14.2, U6.6 (A)
OUTPUT_EN_RX_B: J3.2, R14.1, U6.7 (B)
OUTPUT_EN_TX_A: J4.1, R16.2, U8.6 (A)
OUTPUT_EN_TX_B: J4.2, R16.1, U8.7 (B)
QA1: U11.15 (QA); also elsewhere on the board
QA2: U12.15 (QA); also elsewhere on the board
QA3: U13.15 (QA); also elsewhere on the board
QA4: U14.15 (QA); also elsewhere on the board
QA5: U9.15 (QA); also elsewhere on the board
QA6: U29.15 (QA); also elsewhere on the board
QA7: U30.15 (QA); also elsewhere on the board
QA8: U31.15 (QA); also elsewhere on the board
QB1: U11.1 (QB); also elsewhere on the board
QB2: U12.1 (QB); also elsewhere on the board
QB3: U13.1 (QB); also elsewhere on the board
QB4: U14.1 (QB); also elsewhere on the board
QB5: U9.1 (QB); also elsewhere on the board
QB6: U29.1 (QB); also elsewhere on the board
QB7: U30.1 (QB); also elsewhere on the board
QB8: U31.1 (QB); also elsewhere on the board
QC1: U11.2 (QC); also elsewhere on the board
QC2: U12.2 (QC); also elsewhere on the board
QC3: U13.2 (QC); also elsewhere on the board
QC4: U14.2 (QC); also elsewhere on the board
QC5: U9.2 (QC); also elsewhere on the board
QC6: U29.2 (QC); also elsewhere on the board
QC7: U30.2 (QC); also elsewhere on the board
QC8: U31.2 (QC); also elsewhere on the board
QD1: U11.3 (QD); also elsewhere on the board
QD2: U12.3 (QD); also elsewhere on the board
QD3: U13.3 (QD); also elsewhere on the board
QD4: U14.3 (QD); also elsewhere on the board
QD5: U9.3 (QD); also elsewhere on the board
QD6: U29.3 (QD); also elsewhere on the board
QD7: U30.3 (QD); also elsewhere on the board
QD8: U31.3 (QD); also elsewhere on the board
QE1: U11.4 (QE); also elsewhere on the board
QE2: U12.4 (QE); also elsewhere on the board
QE3: U13.4 (QE); also elsewhere on the board
QE4: U14.4 (QE); also elsewhere on the board
QE5: U9.4 (QE); also elsewhere on the board
QE6: U29.4 (QE); also elsewhere on the board
QE7: U30.4 (QE); also elsewhere on the board
QE8: U31.4 (QE); also elsewhere on the board
QF1: U11.5 (QF); also elsewhere on the board
QF2: U12.5 (QF); also elsewhere on the board
QF3: U13.5 (QF); also elsewhere on the board
QF4: U14.5 (QF); also elsewhere on the board
QF5: U9.5 (QF); also elsewhere on the board
QF6: U29.5 (QF); also elsewhere on the board
QF7: U30.5 (QF); also elsewhere on the board
QF8: U31.5 (QF); also elsewhere on the board
QG1: U11.6 (QG); also elsewhere on the board
QG2: U12.6 (QG); also elsewhere on the board
QG3: U13.6 (QG); also elsewhere on the board
QG4: U14.6 (QG); also elsewhere on the board
QG5: U9.6 (QG); also elsewhere on the board
QG6: U29.6 (QG); also elsewhere on the board
QG7: U30.6 (QG); also elsewhere on the board
QG8: U31.6 (QG); also elsewhere on the board
QH1: U11.7 (QH); also elsewhere on the board
QH2: U12.7 (QH); also elsewhere on the board
QH3: U13.7 (QH); also elsewhere on the board
QH4: U14.7 (QH); also elsewhere on the board
QH5: U9.7 (QH); also elsewhere on the board
QH6: U29.7 (QH); also elsewhere on the board
QH7: U30.7 (QH); also elsewhere on the board
QH8: U31.7 (QH); also elsewhere on the board
SHIFT_CLK: J1.10, R19.2
SHIFT_CLK_BUF: J2.3, R4.2, R30.2, R35.2, R40.2, R45.2, R78.2, R83.2, R88.2, R93.2, U10.16 (Y2)
SHIFT_CLK_RX485: J1.9, U2.1 (RO)
SHIFT_CLK_RX_A: J3.5, R6.2, U2.6 (A)
SHIFT_CLK_RX_B: J3.6, R6.1, U2.7 (B)
SHIFT_CLK_TX_A: J4.5, R8.2, U4.6 (A)
SHIFT_CLK_TX_B: J4.6, R8.1, U4.7 (B)
SH_REG_1_TO_2: R34.2, U11.9 (QH')
SH_REG_2_TO_3: R39.2, U12.9 (QH')
SH_REG_3_TO_4: R44.2, U13.9 (QH')
SH_REG_4_TO_5: R77.2, U14.9 (QH')
SH_REG_5_TO_6: R82.2, U9.9 (QH')
SH_REG_6_TO_7: R87.2, U29.9 (QH')
SH_REG_7_TO_8: R92.2, U30.9 (QH')

Notes on the sheet:
Power Supply
Signal buffering
RS485 TX Drivers
RS485 RX Drivers
Input/Output signals
RS485 IN (RX)
HC595 and solenoid drivers
12V Supply

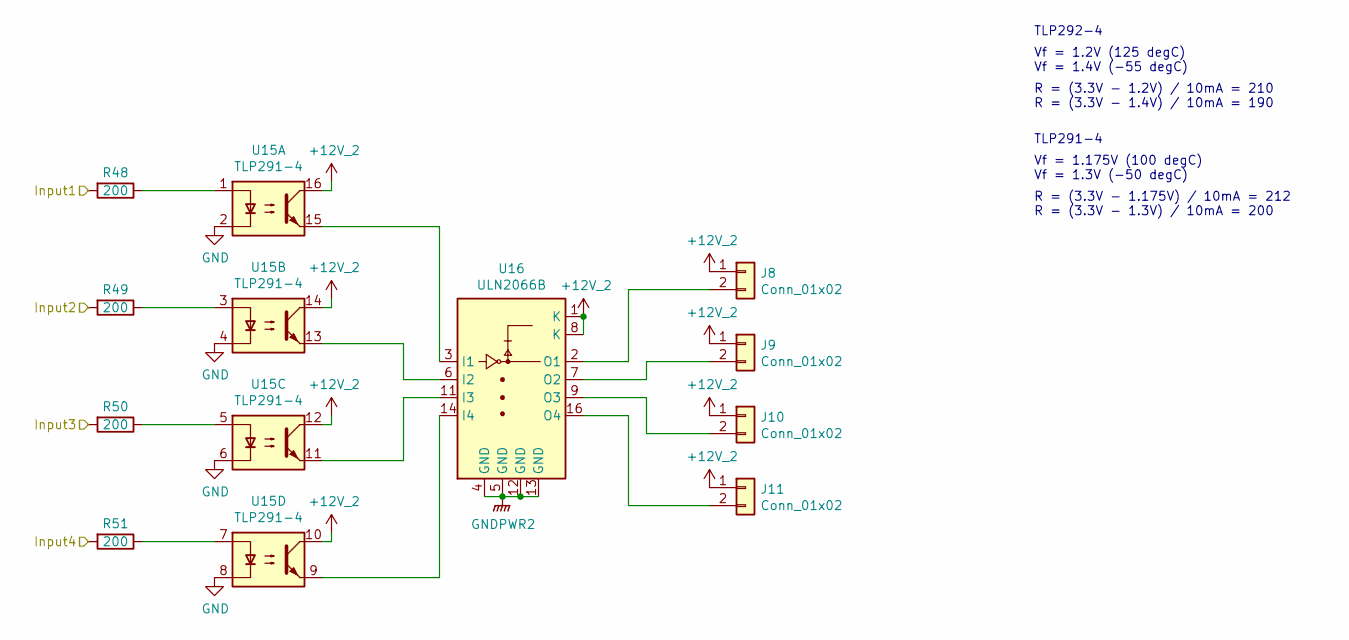
[picture p27: schematic SolenoidDriverx4_2.sch]

Parts:
J8, J9, J10, J11: Conn_01x02; SolderWirePad_1x02_P3.81mm_Drill1.2mm_Diam2.5mm
R48, R49, R50, R51: 200; R_0603_1608Metric_ValInMiddleFABlayer
U15: TLP291-4; SOIC-16_4.55x10.3mm_P1.27mm
U16: ULN2066B; DIP-16_346_ELL

Connections:
+12V_2: J8.1, J9.1, J10.1, J11.1, U15.10, U15.12, U15.14, U15.16, U16.1 (K), U16.8 (K); also elsewhere on the board
GND: U15.2, U15.4, U15.6, U15.8; also elsewhere on the board
GNDPWR2: U16.4 (GND), U16.5 (GND), U16.12 (GND), U16.13 (GND); also elsewhere on the board
unnamed: J8.2, U16.2 (O1)
unnamed: J9.2, U16.7 (O2)
unnamed: J10.2, U16.9 (O3)
unnamed: J11.2, U16.16 (O4)
unnamed: R48.1, U15.1
unnamed: R49.1, U15.3
unnamed: R50.1, U15.5
unnamed: R51.1, U15.7
unnamed: U15.9, U16.14 (I4)
unnamed: U15.11, U16.11 (I3)
unnamed: U15.13, U16.6 (I2)
unnamed: U15.15, U16.3 (I1)
QE1: R51.2; also elsewhere on the board
QF1: R50.2; also elsewhere on the board
QG1: R49.2; also elsewhere on the board
QH1: R48.2; also elsewhere on the board

Parts of its further copies:
J44, J45, J46, J47, J48, J49, J50, J51, J52, J53, J54, J55, J56, J57, J58, J59, J60, J61, J62, J63, J64, J65, J66, J67, J68, J69, J70, J71: Conn_01x02; SolderWirePad_1x02_P3.81mm_Drill1.2mm_Diam2.5mm
R104, R105, R106, R107, R108, R109, R110, R111, R112, R113, R114, R115, R116, R117, R118, R119, R120, R121, R122, R123, R124, R125, R126, R127, R128, R129, R130, R131: 200; R_0603_1608Metric_ValInMiddleFABlayer
U36, U38, U40, U42, U44, U46, U48: TLP291-4; SOIC-16_4.55x10.3mm_P1.27mm
U37, U39, U41, U43, U45, U47, U49: ULN2066B; DIP-16_346_ELL

Connections of its further copies:
+12V_2: J44.1, J45.1, J46.1, J47.1, J48.1, J49.1, J50.1, J51.1, J52.1, J53.1, J54.1, J55.1, J56.1, J57.1, J58.1, J59.1, J60.1, J61.1, J62.1, J63.1, J64.1, J65.1, J66.1, J67.1, J68.1, J69.1, J70.1, J71.1, U36.10, U36.12, U36.14, U36.16, U37.1 (K), U37.8 (K), U38.10, U38.12, U38.14, U38.16, U39.1 (K), U39.8 (K), U40.10, U40.12, U40.14, U40.16, U41.1 (K), U41.8 (K), U42.10, U42.12, U42.14, U42.16, U43.1 (K), U43.8 (K), U44.10, U44.12, U44.14, U44.16, U45.1 (K), U45.8 (K), U46.10, U46.12, U46.14, U46.16, U47.1 (K), U47.8 (K), U48.10, U48.12, U48.14, U48.16, U49.1 (K), U49.8 (K); also elsewhere on the board
GND: U36.2, U36.4, U36.6, U36.8, U38.2, U38.4, U38.6, U38.8, U40.2, U40.4, U40.6, U40.8, U42.2, U42.4, U42.6, U42.8, U44.2, U44.4, U44.6, U44.8, U46.2, U46.4, U46.6, U46.8, U48.2, U48.4, U48.6, U48.8; also elsewhere on the board
GNDPWR2: U37.4 (GND), U37.5 (GND), U37.12 (GND), U37.13 (GND), U39.4 (GND), U39.5 (GND), U39.12 (GND), U39.13 (GND), U41.4 (GND), U41.5 (GND), U41.12 (GND), U41.13 (GND), U43.4 (GND), U43.5 (GND), U43.12 (GND), U43.13 (GND), U45.4 (GND), U45.5 (GND), U45.12 (GND), U45.13 (GND), U47.4 (GND), U47.5 (GND), U47.12 (GND), U47.13 (GND), U49.4 (GND), U49.5 (GND), U49.12 (GND), U49.13 (GND); also elsewhere on the board
unnamed: J44.2, U37.2 (O1)
unnamed: J45.2, U37.7 (O2)
unnamed: J46.2, U37.9 (O3)
unnamed: J47.2, U37.16 (O4)
unnamed: J48.2, U39.2 (O1)
unnamed: J49.2, U39.7 (O2)
unnamed: J50.2, U39.9 (O3)
unnamed: J51.2, U39.16 (O4)
unnamed: J52.2, U41.2 (O1)
unnamed: J53.2, U41.7 (O2)
unnamed: J54.2, U41.9 (O3)
unnamed: J55.2, U41.16 (O4)
unnamed: J56.2, U43.2 (O1)
unnamed: J57.2, U43.7 (O2)
unnamed: J58.2, U43.9 (O3)
unnamed: J59.2, U43.16 (O4)
unnamed: J60.2, U45.2 (O1)
unnamed: J61.2, U45.7 (O2)
unnamed: J62.2, U45.9 (O3)
unnamed: J63.2, U45.16 (O4)
unnamed: J64.2, U47.2 (O1)
unnamed: J65.2, U47.7 (O2)
unnamed: J66.2, U47.9 (O3)
unnamed: J67.2, U47.16 (O4)
unnamed: J68.2, U49.2 (O1)
unnamed: J69.2, U49.7 (O2)
unnamed: J70.2, U49.9 (O3)
unnamed: J71.2, U49.16 (O4)
unnamed: R104.1, U36.1
unnamed: R105.1, U36.3
unnamed: R106.1, U36.5
unnamed: R107.1, U36.7
unnamed: R108.1, U38.1
unnamed: R109.1, U38.3
unnamed: R110.1, U38.5
unnamed: R111.1, U38.7
unnamed: R112.1, U40.1
unnamed: R113.1, U40.3
unnamed: R114.1, U40.5
unnamed: R115.1, U40.7
unnamed: R116.1, U42.1
unnamed: R117.1, U42.3
unnamed: R118.1, U42.5
unnamed: R119.1, U42.7
unnamed: R120.1, U44.1
unnamed: R121.1, U44.3
unnamed: R122.1, U44.5
unnamed: R123.1, U44.7
unnamed: R124.1, U46.1
unnamed: R125.1, U46.3
unnamed: R126.1, U46.5
unnamed: R127.1, U46.7
unnamed: R128.1, U48.1
unnamed: R129.1, U48.3
unnamed: R130.1, U48.5
unnamed: R131.1, U48.7
unnamed: U36.9, U37.14 (I4)
unnamed: U36.11, U37.11 (I3)
unnamed: U36.13, U37.6 (I2)
unnamed: U36.15, U37.3 (I1)
unnamed: U38.9, U39.14 (I4)
unnamed: U38.11, U39.11 (I3)
unnamed: U38.13, U39.6 (I2)
unnamed: U38.15, U39.3 (I1)
unnamed: U40.9, U41.14 (I4)
unnamed: U40.11, U41.11 (I3)
unnamed: U40.13, U41.6 (I2)
unnamed: U40.15, U41.3 (I1)
unnamed: U42.9, U43.14 (I4)
unnamed: U42.11, U43.11 (I3)
unnamed: U42.13, U43.6 (I2)
unnamed: U42.15, U43.3 (I1)
unnamed: U44.9, U45.14 (I4)
unnamed: U44.11, U45.11 (I3)
unnamed: U44.13, U45.6 (I2)
unnamed: U44.15, U45.3 (I1)
unnamed: U46.9, U47.14 (I4)
unnamed: U46.11, U47.11 (I3)
unnamed: U46.13, U47.6 (I2)
unnamed: U46.15, U47.3 (I1)
unnamed: U48.9, U49.14 (I4)
unnamed: U48.11, U49.11 (I3)
unnamed: U48.13, U49.6 (I2)
unnamed: U48.15, U49.3 (I1)
QE2: R107.2; also elsewhere on the board
QE3: R111.2; also elsewhere on the board
QE4: R115.2; also elsewhere on the board
QE5: R119.2; also elsewhere on the board
QE6: R123.2; also elsewhere on the board
QE7: R127.2; also elsewhere on the board
QE8: R131.2; also elsewhere on the board
QF2: R106.2; also elsewhere on the board
QF3: R110.2; also elsewhere on the board
QF4: R114.2; also elsewhere on the board
QF5: R118.2; also elsewhere on the board
QF6: R122.2; also elsewhere on the board
QF7: R126.2; also elsewhere on the board
QF8: R130.2; also elsewhere on the board
QG2: R105.2; also elsewhere on the board
QG3: R109.2; also elsewhere on the board
QG4: R113.2; also elsewhere on the board
QG5: R117.2; also elsewhere on the board
QG6: R121.2; also elsewhere on the board
QG7: R125.2; also elsewhere on the board
QG8: R129.2; also elsewhere on the board
QH2: R104.2; also elsewhere on the board
QH3: R108.2; also elsewhere on the board
QH4: R112.2; also elsewhere on the board
QH5: R116.2; also elsewhere on the board
QH6: R120.2; also elsewhere on the board
QH7: R124.2; also elsewhere on the board
QH8: R128.2; also elsewhere on the board

Notes on the sheet:
R = (3.3V - 1.2V) / 10mA = 210 R = (3.3V - 1.4V) / 10mA = 190
Vf = 1.2V (125 degC) Vf = 1.4V (-55 degC)
TLP292-4
R = (3.3V - 1.175V) / 10mA = 212 R = (3.3V - 1.3V) / 10mA = 200
Vf = 1.175V (100 degC) Vf = 1.3V (-50 degC)
TLP291-4

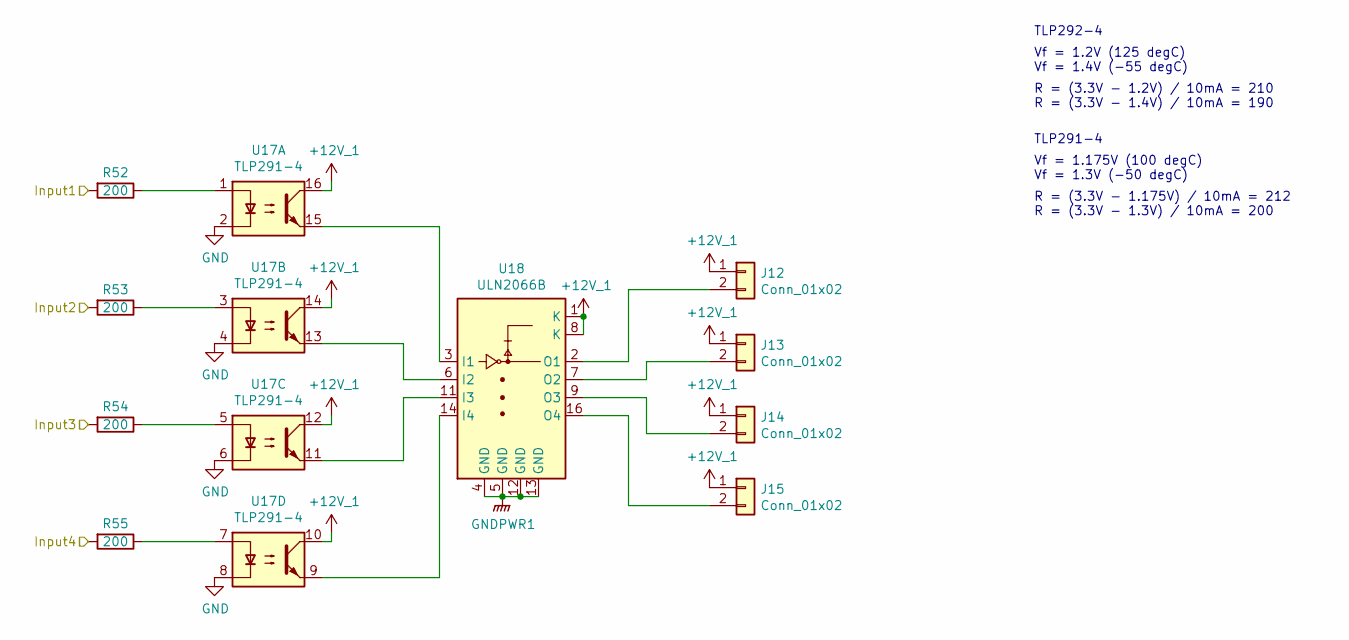
[picture p28: schematic SolenoidDriverx4_1.sch]

Parts:
J12, J13, J14, J15: Conn_01x02; SolderWirePad_1x02_P3.81mm_Drill1.2mm_Diam2.5mm
R52, R53, R54, R55: 200; R_0603_1608Metric_ValInMiddleFABlayer
U17: TLP291-4; SOIC-16_4.55x10.3mm_P1.27mm
U18: ULN2066B; DIP-16_346_ELL

Connections:
+12V_1: J12.1, J13.1, J14.1, J15.1, U17.10, U17.12, U17.14, U17.16, U18.1 (K), U18.8 (K); also elsewhere on the board
GND: U17.2, U17.4, U17.6, U17.8; also elsewhere on the board
GNDPWR1: U18.4 (GND), U18.5 (GND), U18.12 (GND), U18.13 (GND); also elsewhere on the board
unnamed: J12.2, U18.2 (O1)
unnamed: J13.2, U18.7 (O2)
unnamed: J14.2, U18.9 (O3)
unnamed: J15.2, U18.16 (O4)
unnamed: R52.1, U17.1
unnamed: R53.1, U17.3
unnamed: R54.1, U17.5
unnamed: R55.1, U17.7
unnamed: U17.9, U18.14 (I4)
unnamed: U17.11, U18.11 (I3)
unnamed: U17.13, U18.6 (I2)
unnamed: U17.15, U18.3 (I1)
QA1: R52.2; also elsewhere on the board
QB1: R53.2; also elsewhere on the board
QC1: R54.2; also elsewhere on the board
QD1: R55.2; also elsewhere on the board

Parts of its further copies:
J16, J17, J18, J19, J20, J21, J22, J23, J24, J25, J26, J27, J28, J29, J30, J31, J32, J33, J34, J35, J36, J37, J38, J39, J40, J41, J42, J43: Conn_01x02; SolderWirePad_1x02_P3.81mm_Drill1.2mm_Diam2.5mm
R56, R57, R58, R59, R60, R61, R62, R63, R64, R65, R66, R67, R68, R69, R70, R71, R72, R73, R74, R75, R96, R97, R98, R99, R100, R101, R102, R103: 200; R_0603_1608Metric_ValInMiddleFABlayer
U19, U21, U23, U25, U27, U32, U34: TLP291-4; SOIC-16_4.55x10.3mm_P1.27mm
U20, U22, U24, U26, U28, U33, U35: ULN2066B; DIP-16_346_ELL

Connections of its further copies:
+12V_1: J16.1, J17.1, J18.1, J19.1, J20.1, J21.1, J22.1, J23.1, J24.1, J25.1, J26.1, J27.1, J28.1, J29.1, J30.1, J31.1, J32.1, J33.1, J34.1, J35.1, J36.1, J37.1, J38.1, J39.1, J40.1, J41.1, J42.1, J43.1, U19.10, U19.12, U19.14, U19.16, U20.1 (K), U20.8 (K), U21.10, U21.12, U21.14, U21.16, U22.1 (K), U22.8 (K), U23.10, U23.12, U23.14, U23.16, U24.1 (K), U24.8 (K), U25.10, U25.12, U25.14, U25.16, U26.1 (K), U26.8 (K), U27.10, U27.12, U27.14, U27.16, U28.1 (K), U28.8 (K), U32.10, U32.12, U32.14, U32.16, U33.1 (K), U33.8 (K), U34.10, U34.12, U34.14, U34.16, U35.1 (K), U35.8 (K); also elsewhere on the board
GND: U19.2, U19.4, U19.6, U19.8, U21.2, U21.4, U21.6, U21.8, U23.2, U23.4, U23.6, U23.8, U25.2, U25.4, U25.6, U25.8, U27.2, U27.4, U27.6, U27.8, U32.2, U32.4, U32.6, U32.8, U34.2, U34.4, U34.6, U34.8; also elsewhere on the board
GNDPWR1: U20.4 (GND), U20.5 (GND), U20.12 (GND), U20.13 (GND), U22.4 (GND), U22.5 (GND), U22.12 (GND), U22.13 (GND), U24.4 (GND), U24.5 (GND), U24.12 (GND), U24.13 (GND), U26.4 (GND), U26.5 (GND), U26.12 (GND), U26.13 (GND), U28.4 (GND), U28.5 (GND), U28.12 (GND), U28.13 (GND), U33.4 (GND), U33.5 (GND), U33.12 (GND), U33.13 (GND), U35.4 (GND), U35.5 (GND), U35.12 (GND), U35.13 (GND); also elsewhere on the board
unnamed: J16.2, U20.2 (O1)
unnamed: J17.2, U20.7 (O2)
unnamed: J18.2, U20.9 (O3)
unnamed: J19.2, U20.16 (O4)
unnamed: J20.2, U22.2 (O1)
unnamed: J21.2, U22.7 (O2)
unnamed: J22.2, U22.9 (O3)
unnamed: J23.2, U22.16 (O4)
unnamed: J24.2, U24.2 (O1)
unnamed: J25.2, U24.7 (O2)
unnamed: J26.2, U24.9 (O3)
unnamed: J27.2, U24.16 (O4)
unnamed: J28.2, U26.2 (O1)
unnamed: J29.2, U26.7 (O2)
unnamed: J30.2, U26.9 (O3)
unnamed: J31.2, U26.16 (O4)
unnamed: J32.2, U28.2 (O1)
unnamed: J33.2, U28.7 (O2)
unnamed: J34.2, U28.9 (O3)
unnamed: J35.2, U28.16 (O4)
unnamed: J36.2, U33.2 (O1)
unnamed: J37.2, U33.7 (O2)
unnamed: J38.2, U33.9 (O3)
unnamed: J39.2, U33.16 (O4)
unnamed: J40.2, U35.2 (O1)
unnamed: J41.2, U35.7 (O2)
unnamed: J42.2, U35.9 (O3)
unnamed: J43.2, U35.16 (O4)
unnamed: R56.1, U19.1
unnamed: R57.1, U19.3
unnamed: R58.1, U19.5
unnamed: R59.1, U19.7
unnamed: R60.1, U21.1
unnamed: R61.1, U21.3
unnamed: R62.1, U21.5
unnamed: R63.1, U21.7
unnamed: R64.1, U23.1
unnamed: R65.1, U23.3
unnamed: R66.1, U23.5
unnamed: R67.1, U23.7
unnamed: R68.1, U25.1
unnamed: R69.1, U25.3
unnamed: R70.1, U25.5
unnamed: R71.1, U25.7
unnamed: R72.1, U27.1
unnamed: R73.1, U27.3
unnamed: R74.1, U27.5
unnamed: R75.1, U27.7
unnamed: R96.1, U32.1
unnamed: R97.1, U32.3
unnamed: R98.1, U32.5
unnamed: R99.1, U32.7
unnamed: R100.1, U34.1
unnamed: R101.1, U34.3
unnamed: R102.1, U34.5
unnamed: R103.1, U34.7
unnamed: U19.9, U20.14 (I4)
unnamed: U19.11, U20.11 (I3)
unnamed: U19.13, U20.6 (I2)
unnamed: U19.15, U20.3 (I1)
unnamed: U21.9, U22.14 (I4)
unnamed: U21.11, U22.11 (I3)
unnamed: U21.13, U22.6 (I2)
unnamed: U21.15, U22.3 (I1)
unnamed: U23.9, U24.14 (I4)
unnamed: U23.11, U24.11 (I3)
unnamed: U23.13, U24.6 (I2)
unnamed: U23.15, U24.3 (I1)
unnamed: U25.9, U26.14 (I4)
unnamed: U25.11, U26.11 (I3)
unnamed: U25.13, U26.6 (I2)
unnamed: U25.15, U26.3 (I1)
unnamed: U27.9, U28.14 (I4)
unnamed: U27.11, U28.11 (I3)
unnamed: U27.13, U28.6 (I2)
unnamed: U27.15, U28.3 (I1)
unnamed: U32.9, U33.14 (I4)
unnamed: U32.11, U33.11 (I3)
unnamed: U32.13, U33.6 (I2)
unnamed: U32.15, U33.3 (I1)
unnamed: U34.9, U35.14 (I4)
unnamed: U34.11, U35.11 (I3)
unnamed: U34.13, U35.6 (I2)
unnamed: U34.15, U35.3 (I1)
QA2: R56.2; also elsewhere on the board
QA3: R60.2; also elsewhere on the board
QA4: R64.2; also elsewhere on the board
QA5: R68.2; also elsewhere on the board
QA6: R72.2; also elsewhere on the board
QA7: R96.2; also elsewhere on the board
QA8: R100.2; also elsewhere on the board
QB2: R57.2; also elsewhere on the board
QB3: R61.2; also elsewhere on the board
QB4: R65.2; also elsewhere on the board
QB5: R69.2; also elsewhere on the board
QB6: R73.2; also elsewhere on the board
QB7: R97.2; also elsewhere on the board
QB8: R101.2; also elsewhere on the board
QC2: R58.2; also elsewhere on the board
QC3: R62.2; also elsewhere on the board
QC4: R66.2; also elsewhere on the board
QC5: R70.2; also elsewhere on the board
QC6: R74.2; also elsewhere on the board
QC7: R98.2; also elsewhere on the board
QC8: R102.2; also elsewhere on the board
QD2: R59.2; also elsewhere on the board
QD3: R63.2; also elsewhere on the board
QD4: R67.2; also elsewhere on the board
QD5: R71.2; also elsewhere on the board
QD6: R75.2; also elsewhere on the board
QD7: R99.2; also elsewhere on the board
QD8: R103.2; also elsewhere on the board

Notes on the sheet:
R = (3.3V - 1.2V) / 10mA = 210 R = (3.3V - 1.4V) / 10mA = 190
Vf = 1.2V (125 degC) Vf = 1.4V (-55 degC)
TLP292-4
R = (3.3V - 1.175V) / 10mA = 212 R = (3.3V - 1.3V) / 10mA = 200
Vf = 1.175V (100 degC) Vf = 1.3V (-50 degC)
TLP291-4

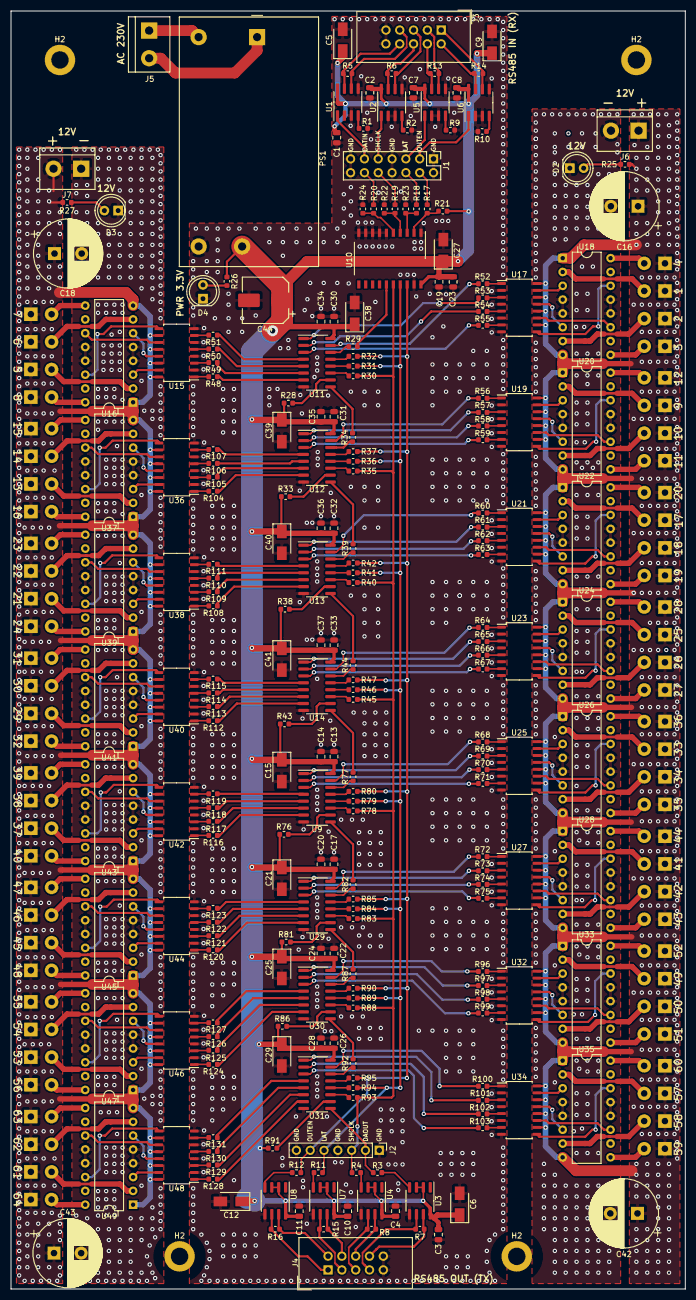
[picture p29: board Hc595_Solenoid_Driver.kicad_pcb from above]

Board: 2 copper layers, 124.0 x 235.0 mm, 303 parts (0 on the bottom side), 355 nets.

Other parts of the board:
H2, H2#2, H2#3, H2#4: MountingHole_3.2mm_M3_DIN965_Pad_ModifFABlayer
