kurdish-yoda/TOS/PCB/TonOfSteppers.kicad_pcb

## KiCad design PCB/TonOfSteppers.kicad_pcb (2021-04-03)

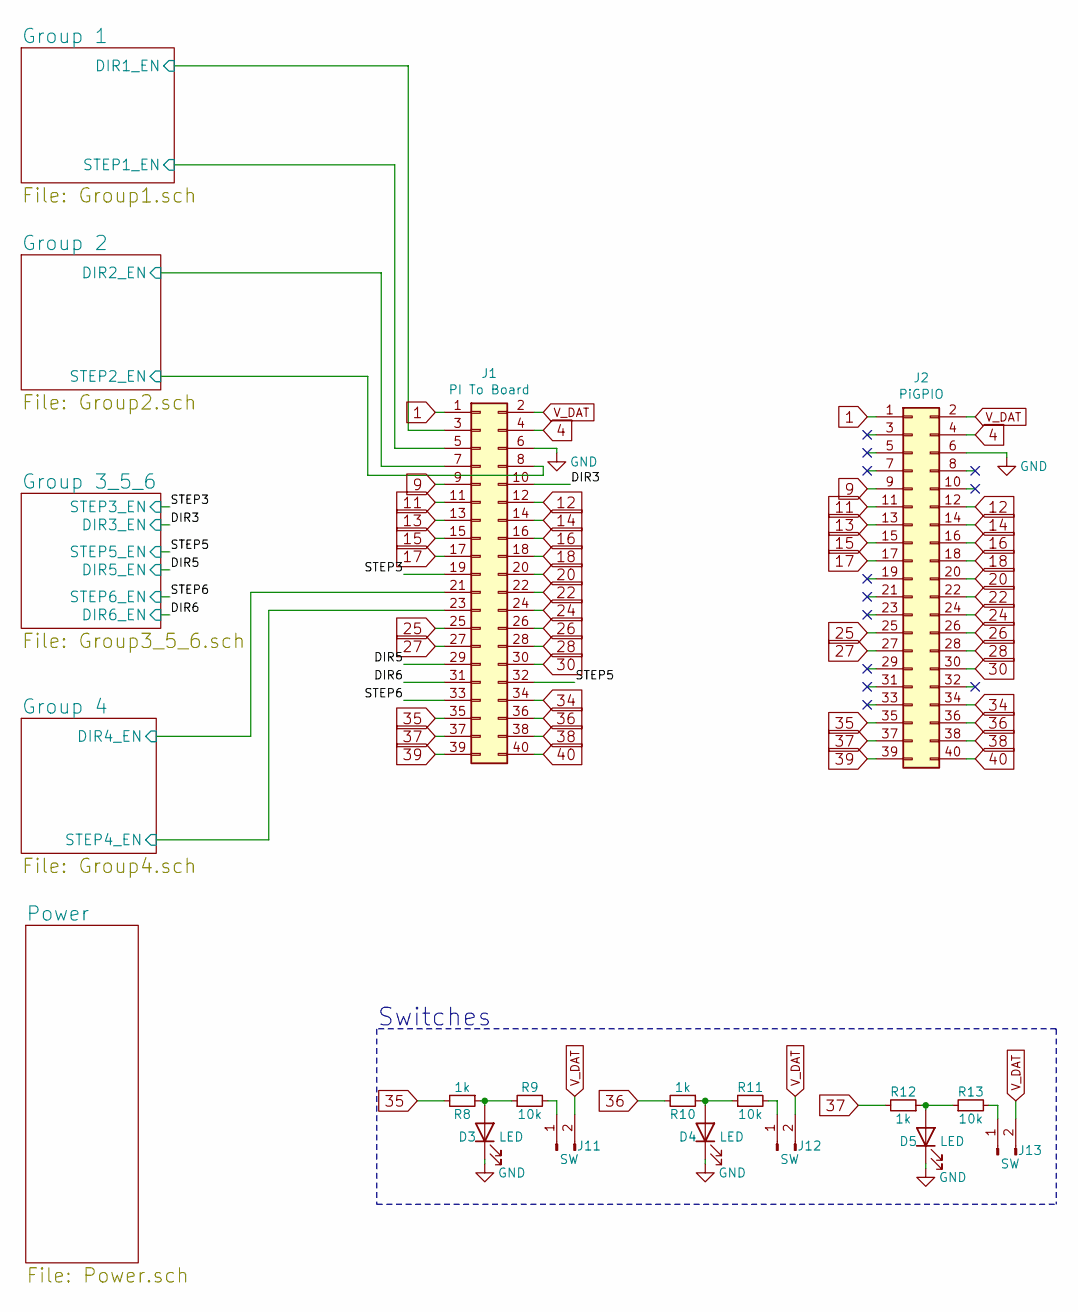
[picture p30: schematic TonOfSteppers.sch]

Parts:
D3, D4, D5: LED; D_0805_2012Metric_Pad1.15x1.40mm_HandSolder
J1: PI To Board; PinHeader_2x20_P2.54mm_Vertical_SMD
J2: PiGPIO; PinHeader_2x20_P2.54mm_Vertical_SMD
J11, J12, J13: SW; JST_PH_B2B-PH-K_1x02_P2.00mm_Vertical
R8, R10, R12: 1k; R_0805_2012Metric_Pad1.20x1.40mm_HandSolder
R9, R11, R13: 10k; R_0805_2012Metric_Pad1.20x1.40mm_HandSolder

Connections:
1: J1.1, J2.1
4: J1.4, J2.4
9: J1.9, J2.9
11: J1.11, J2.11
12: J1.12, J2.12
13: J1.13, J2.13
14: J1.14, J2.14
15: J1.15, J2.15
16: J1.16, J2.16
17: J1.17, J2.17
18: J1.18, J2.18
20: J1.20, J2.20
22: J1.22, J2.22
24: J1.24, J2.24
25: J1.25, J2.25
26: J1.26, J2.26
27: J1.27, J2.27
28: J1.28, J2.28
30: J1.30, J2.30
34: J1.34, J2.34
35: J1.35, J2.35, R8.2
36: J1.36, J2.36, R10.2
37: J1.37, J2.37, R12.2
38: J1.38, J2.38
39: J1.39, J2.39
40: J1.40, J2.40
/DIR3: J1.10; also elsewhere on the board
/DIR5: J1.29; also elsewhere on the board
/DIR6: J1.31; also elsewhere on the board
/Group 1/DIR1_EN: J1.3; also elsewhere on the board
/Group 1/STEP1_EN: J1.5; also elsewhere on the board
/Group 2/DIR2_EN: J1.7; also elsewhere on the board
/Group 2/STEP2_EN: J1.8; also elsewhere on the board
/Group 4/DIR4_EN: J1.21; also elsewhere on the board
/Group 4/STEP4_EN: J1.23; also elsewhere on the board
/STEP3: J1.19; also elsewhere on the board
/STEP5: J1.32; also elsewhere on the board
/STEP6: J1.33; also elsewhere on the board
GND: D3.1 (K), D4.1 (K), D5.1 (K), J1.6, J2.6; also elsewhere on the board
unnamed: D3.2 (A), R8.1, R9.1
unnamed: D4.2 (A), R10.1, R11.1
unnamed: D5.2 (A), R12.1, R13.1
unnamed: J11.1, R9.2
unnamed: J12.1, R11.2
unnamed: J13.1, R13.2
V_DAT: J1.2, J2.2, J11.2, J12.2, J13.2; also elsewhere on the board

Notes on the sheet:
Switches

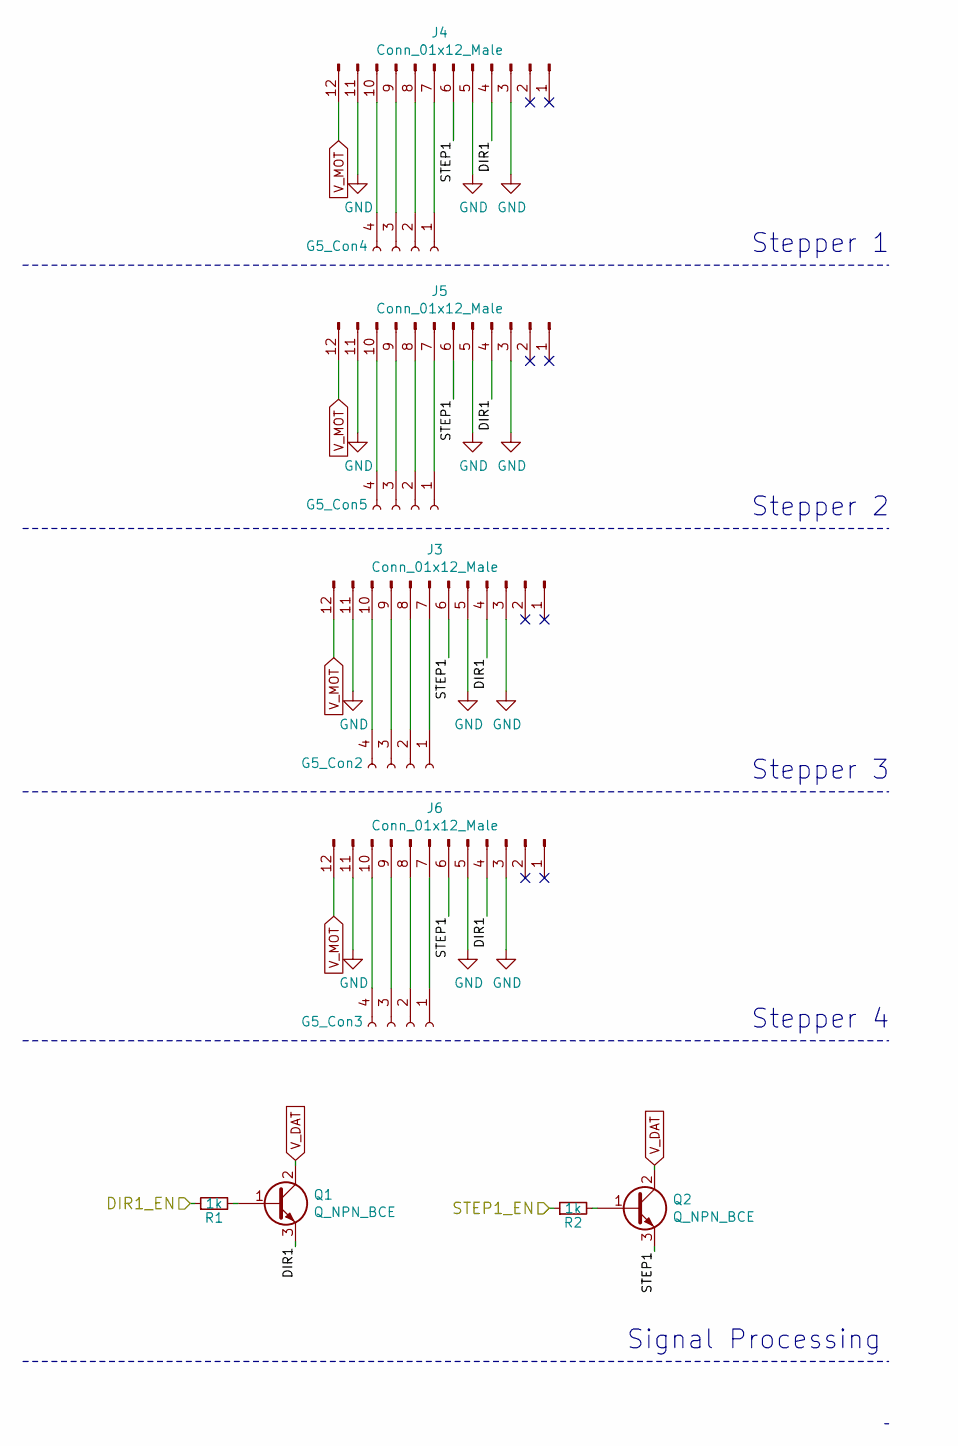
[picture p31: schematic Group1.sch, Tons Of Steppers - Group 1]

Parts:
G5_Con2, G5_Con3, G5_Con4, G5_Con5: Conn_01x04_Female; JST_EH_S4B-EH_1x04_P2.50mm_Horizontal
J3, J4, J5, J6: Conn_01x12_Male; Molex_12PIN
Q1, Q2: Q_NPN_BCE; SOT-89-3_Handsoldering
R1, R2: 1k; R_0805_2012Metric_Pad1.20x1.40mm_HandSolder

Connections:
/Group 1/DIR1: J3.4, J4.4, J5.4, J6.4, Q1.3 (E)
/Group 1/DIR1_EN: R1.1; also elsewhere on the board
/Group 1/STEP1: J3.6, J4.6, J5.6, J6.6, Q2.3 (E)
/Group 1/STEP1_EN: R2.1; also elsewhere on the board
GND: J3.3, J3.5, J3.11, J4.3, J4.5, J4.11, J5.3, J5.5, J5.11, J6.3, J6.5, J6.11; also elsewhere on the board
unnamed: G5_Con2.1, J3.7
unnamed: G5_Con2.2, J3.8
unnamed: G5_Con2.3, J3.9
unnamed: G5_Con2.4, J3.10
unnamed: G5_Con3.1, J6.7
unnamed: G5_Con3.2, J6.8
unnamed: G5_Con3.3, J6.9
unnamed: G5_Con3.4, J6.10
unnamed: G5_Con4.1, J4.7
unnamed: G5_Con4.2, J4.8
unnamed: G5_Con4.3, J4.9
unnamed: G5_Con4.4, J4.10
unnamed: G5_Con5.1, J5.7
unnamed: G5_Con5.2, J5.8
unnamed: G5_Con5.3, J5.9
unnamed: G5_Con5.4, J5.10
unnamed: Q1.1 (B), R1.2
unnamed: Q2.1 (B), R2.2
V_DAT: Q1.2 (C), Q2.2 (C); also elsewhere on the board
V_MOT: J3.12, J4.12, J5.12, J6.12; also elsewhere on the board

Notes on the sheet:
Stepper 1
Stepper 2
Stepper 3
Stepper 4
Signal Processing

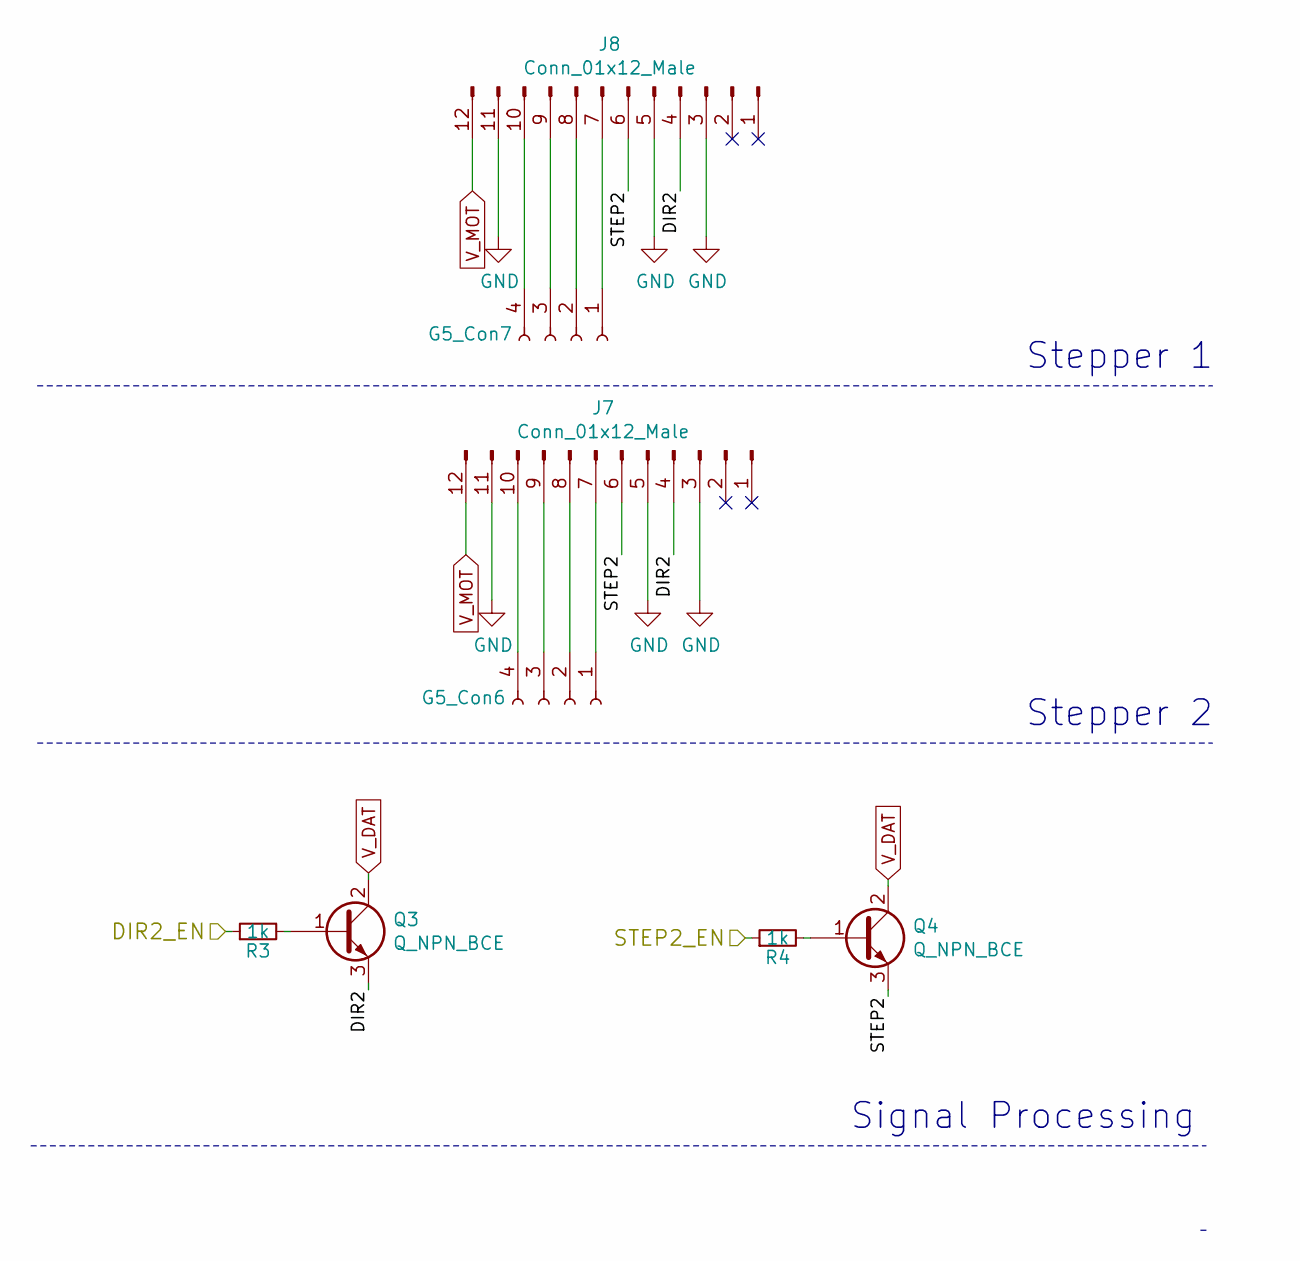
[picture p32: schematic Group2.sch, Tons Of Steppers - Group 2]

Parts:
G5_Con6, G5_Con7: Conn_01x04_Female; JST_EH_S4B-EH_1x04_P2.50mm_Horizontal
J7, J8: Conn_01x12_Male; Molex_12PIN
Q3, Q4: Q_NPN_BCE; SOT-89-3_Handsoldering
R3, R4: 1k; R_0805_2012Metric_Pad1.20x1.40mm_HandSolder

Connections:
/Group 2/DIR2: J7.4, J8.4, Q3.3 (E)
/Group 2/DIR2_EN: R3.1; also elsewhere on the board
/Group 2/STEP2: J7.6, J8.6, Q4.3 (E)
/Group 2/STEP2_EN: R4.1; also elsewhere on the board
GND: J7.3, J7.5, J7.11, J8.3, J8.5, J8.11; also elsewhere on the board
unnamed: G5_Con6.1, J7.7
unnamed: G5_Con6.2, J7.8
unnamed: G5_Con6.3, J7.9
unnamed: G5_Con6.4, J7.10
unnamed: G5_Con7.1, J8.7
unnamed: G5_Con7.2, J8.8
unnamed: G5_Con7.3, J8.9
unnamed: G5_Con7.4, J8.10
unnamed: Q3.1 (B), R3.2
unnamed: Q4.1 (B), R4.2
V_DAT: Q3.2 (C), Q4.2 (C); also elsewhere on the board
V_MOT: J7.12, J8.12; also elsewhere on the board

Notes on the sheet:
Stepper 1
Stepper 2
Signal Processing

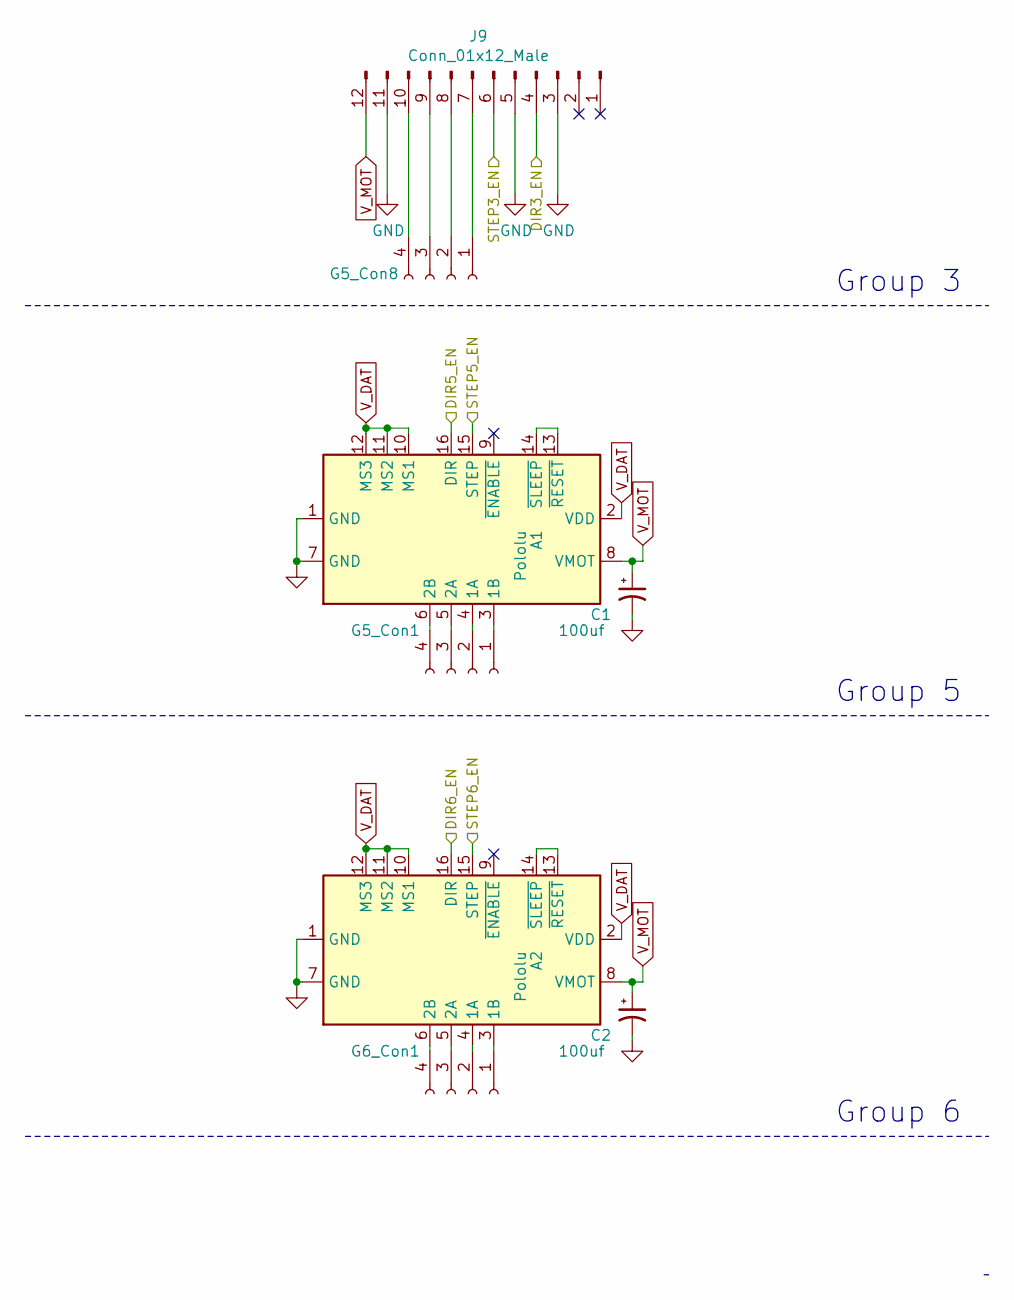
[picture p33: schematic Group3_5_6.sch, Tons Of Steppers - Group 3,5,6]

Parts:
A1, A2: Pololu; Pololu_Breakout-16_15.2x20.3mm
C1, C2: 100uf; CP_Elec_6.3x7.7
G5_Con1, G5_Con8, G6_Con1: Conn_01x04_Female; JST_EH_S4B-EH_1x04_P2.50mm_Horizontal
J9: Conn_01x12_Male; Molex_12PIN

Connections:
/DIR3: J9.4; also elsewhere on the board
/DIR5: A1.16 (DIR); also elsewhere on the board
/DIR6: A2.16 (DIR); also elsewhere on the board
/STEP3: J9.6; also elsewhere on the board
/STEP5: A1.15 (STEP); also elsewhere on the board
/STEP6: A2.15 (STEP); also elsewhere on the board
GND: A1.1 (GND), A1.7 (GND), A2.1 (GND), A2.7 (GND), C1.2, C2.2, J9.3, J9.5, J9.11; also elsewhere on the board
unnamed: A1.3 (1B), G5_Con1.1
unnamed: A1.4 (1A), G5_Con1.2
unnamed: A1.5 (2A), G5_Con1.3
unnamed: A1.6 (2B), G5_Con1.4
unnamed: A1.13 (~RESET), A1.14 (~SLEEP)
unnamed: A2.3 (1B), G6_Con1.1
unnamed: A2.4 (1A), G6_Con1.2
unnamed: A2.5 (2A), G6_Con1.3
unnamed: A2.6 (2B), G6_Con1.4
unnamed: A2.13 (~RESET), A2.14 (~SLEEP)
unnamed: G5_Con8.1, J9.7
unnamed: G5_Con8.2, J9.8
unnamed: G5_Con8.3, J9.9
unnamed: G5_Con8.4, J9.10
V_DAT: A1.2 (VDD), A1.10 (MS1), A1.11 (MS2), A1.12 (MS3), A2.2 (VDD), A2.10 (MS1), A2.11 (MS2), A2.12 (MS3); also elsewhere on the board
V_MOT: A1.8 (VMOT), A2.8 (VMOT), C1.1, C2.1, J9.12; also elsewhere on the board

Notes on the sheet:
Group 3
Group 5
Group 6

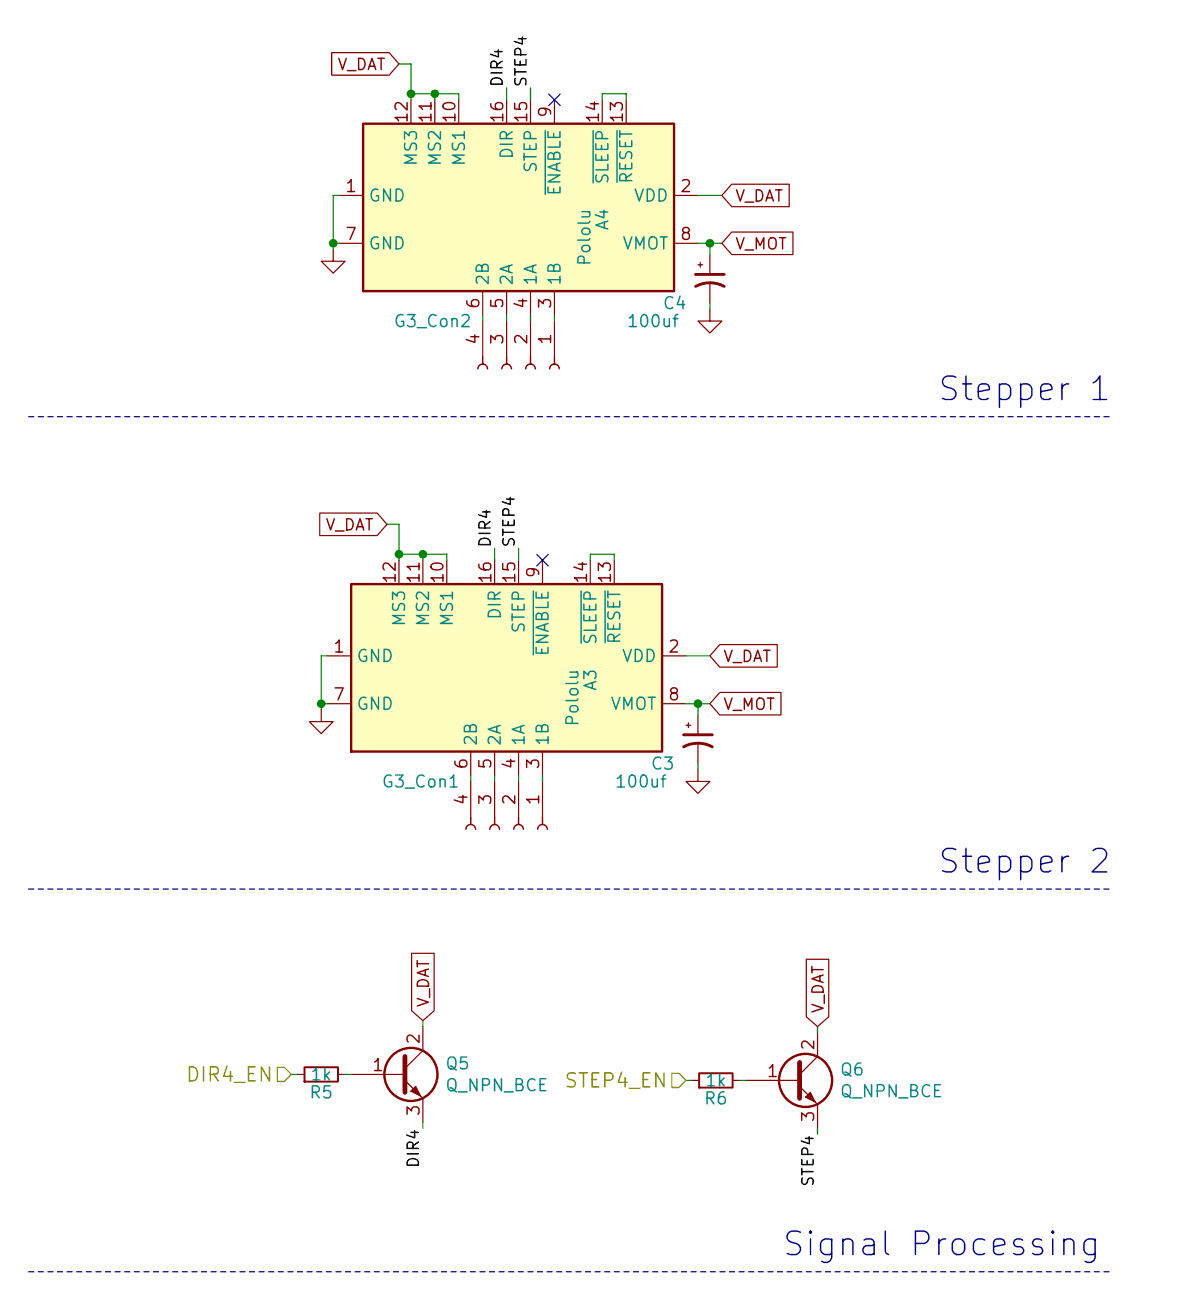
[picture p34: schematic Group4.sch, Tons Of Steppers - Group 4]

Parts:
A3, A4: Pololu; Pololu_Breakout-16_15.2x20.3mm
C3, C4: 100uf; CP_Elec_6.3x7.7
G3_Con1, G3_Con2: Conn_01x04_Female; JST_EH_S4B-EH_1x04_P2.50mm_Horizontal
Q5, Q6: Q_NPN_BCE; SOT-89-3_Handsoldering
R5, R6: 1k; R_0805_2012Metric_Pad1.20x1.40mm_HandSolder

Connections:
/Group 4/DIR4: A3.16 (DIR), A4.16 (DIR), Q5.3 (E)
/Group 4/DIR4_EN: R5.1; also elsewhere on the board
/Group 4/STEP4: A3.15 (STEP), A4.15 (STEP), Q6.3 (E)
/Group 4/STEP4_EN: R6.1; also elsewhere on the board
GND: A3.1 (GND), A3.7 (GND), A4.1 (GND), A4.7 (GND), C3.2, C4.2; also elsewhere on the board
unnamed: A3.3 (1B), G3_Con1.1
unnamed: A3.4 (1A), G3_Con1.2
unnamed: A3.5 (2A), G3_Con1.3
unnamed: A3.6 (2B), G3_Con1.4
unnamed: A3.13 (~RESET), A3.14 (~SLEEP)
unnamed: A4.3 (1B), G3_Con2.1
unnamed: A4.4 (1A), G3_Con2.2
unnamed: A4.5 (2A), G3_Con2.3
unnamed: A4.6 (2B), G3_Con2.4
unnamed: A4.13 (~RESET), A4.14 (~SLEEP)
unnamed: Q5.1 (B), R5.2
unnamed: Q6.1 (B), R6.2
V_DAT: A3.2 (VDD), A3.10 (MS1), A3.11 (MS2), A3.12 (MS3), A4.2 (VDD), A4.10 (MS1), A4.11 (MS2), A4.12 (MS3), Q5.2 (C), Q6.2 (C); also elsewhere on the board
V_MOT: A3.8 (VMOT), A4.8 (VMOT), C3.1, C4.1; also elsewhere on the board

Notes on the sheet:
Stepper 1
Stepper 2
Signal Processing

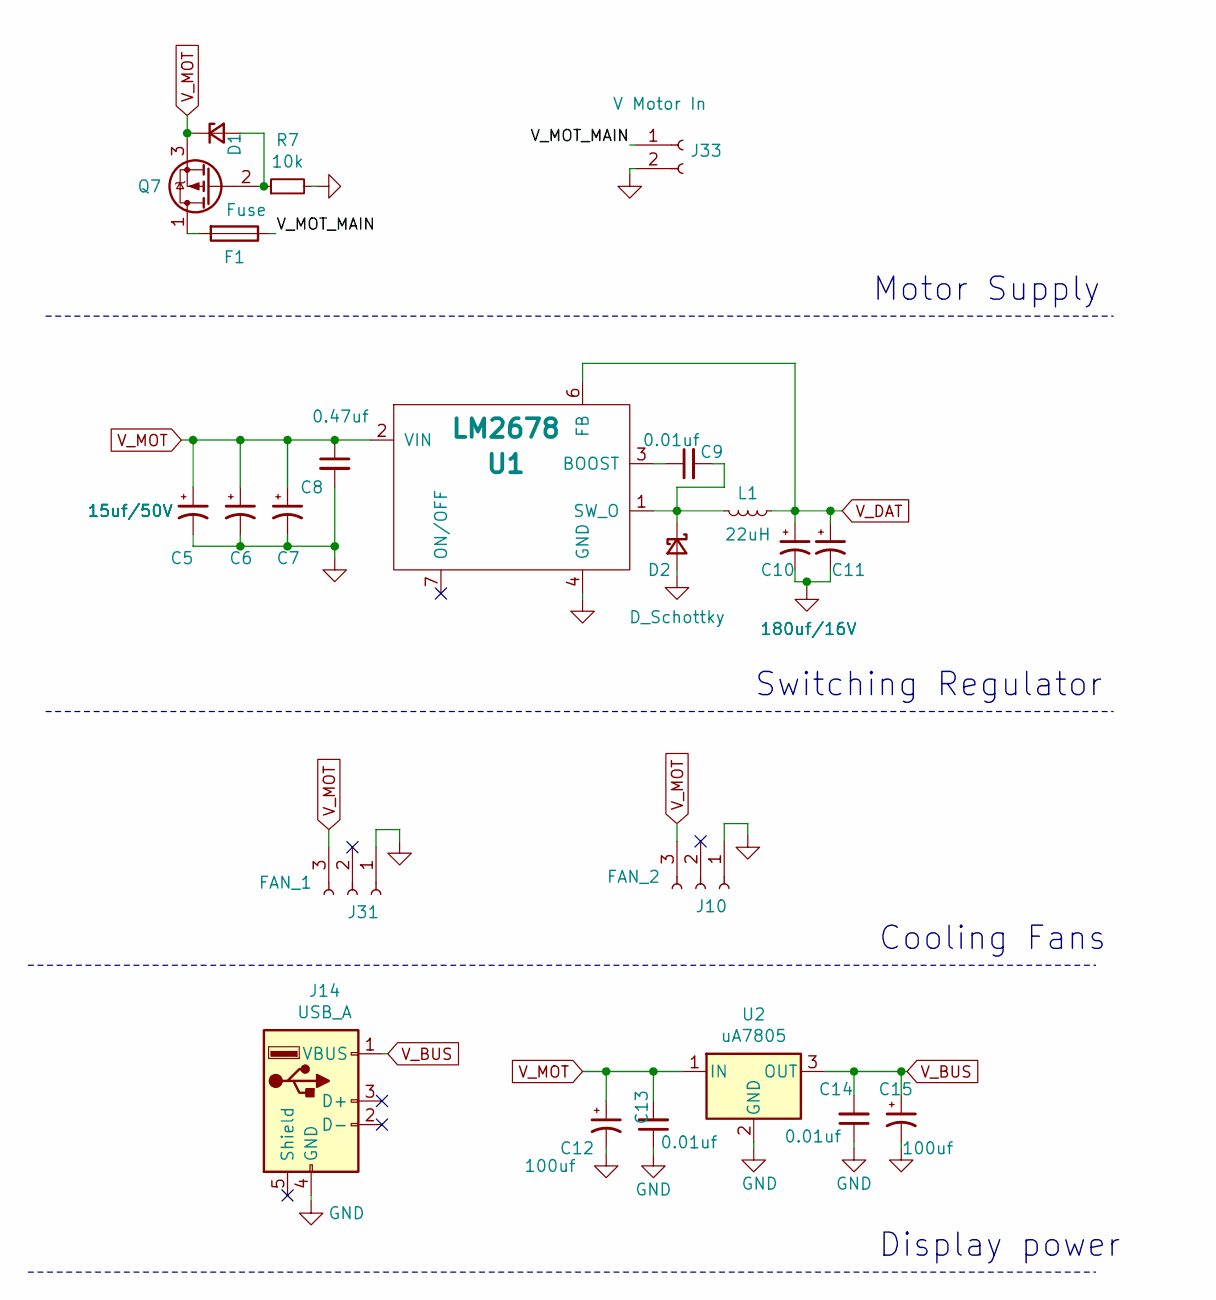
[picture p35: schematic Power.sch, Tons Of Steppers - Power Circuit]

Parts:
C5, C6, C7: 15uf/50V; CP_Elec_4x4.5
C8: 0.47uf; C_0805_2012Metric_Pad1.18x1.45mm_HandSolder
C9, C13, C14: 0.01uf; C_0805_2012Metric_Pad1.18x1.45mm_HandSolder
C10, C11: 180uf/16V; CP_Elec_6.3x7.7
C12, C15: 100uf; CP_Elec_6.3x7.7
D1: D_Zener_Small; D_SMB_Handsoldering
D2: D_Schottky; D_SMC_Handsoldering
F1: Fuse; Fuse_1206_3216Metric_Pad1.42x1.75mm_HandSolder
J10: FAN_2; Molex_KK-254_AE-6410-03A_1x03_P2.54mm_Vertical
J14: USB_A; USB_A_CNCTech_1001-011-01101_Horizontal
J31: FAN_1; Molex_KK-254_AE-6410-03A_1x03_P2.54mm_Vertical
J33: V Motor In; Wago_734-132_1x02_P3.50mm_Vertical
L1: 22uH; L_Wuerth_HCI-1365
Q7: Q_PMOS_DGS; TO-252-3_TabPin2
R7: 10k; R_0805_2012Metric_Pad1.20x1.40mm_HandSolder
U1: LM2678; TO-263-7_TabPin4
U2: uA7805; TO-263-3_TabPin2

Connections:
/Power/V_MOT_MAIN: F1.1, J33.1
GND: C5.2, C6.2, C7.2, C8.2, C10.2, C11.2, C12.2, C13.1, C14.1, C15.2, D2.2 (A), J10.1, J14.4 (GND), J31.1, J33.2, R7.2, U1.4 (GND), U2.2 (GND); also elsewhere on the board
unnamed: C9.1, U1.3 (BOOST)
unnamed: C9.2, D2.1 (K), L1.2, U1.1 (SW_O)
unnamed: D1.2 (A), Q7.2 (G), R7.1
unnamed: F1.2, Q7.1 (D)
V_BUS: C14.2, C15.1, J14.1 (VBUS), U2.3 (OUT); also elsewhere on the board
V_DAT: C10.1, C11.1, L1.1, U1.6 (FB); also elsewhere on the board
V_MOT: C5.1, C6.1, C7.1, C8.1, C12.1, C13.2, D1.1 (K), J10.3, J31.3, Q7.3 (S), U1.2 (VIN), U2.1 (IN); also elsewhere on the board

Notes on the sheet:
Motor Supply
Switching Regulator
Cooling Fans
Display power

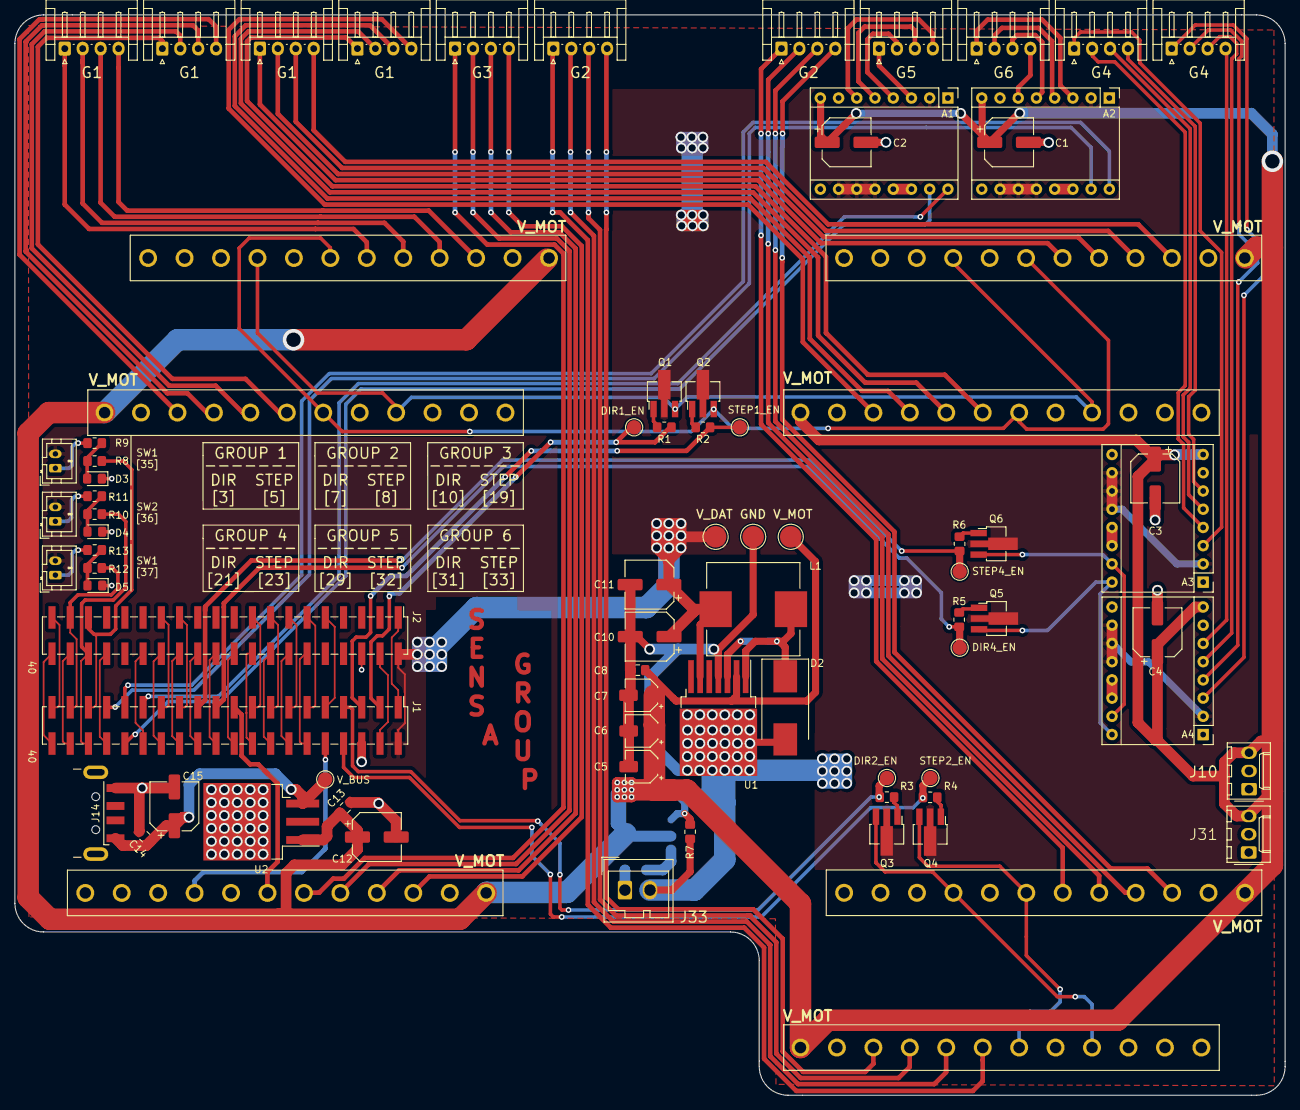
[picture p36: board TonOfSteppers.kicad_pcb from above]

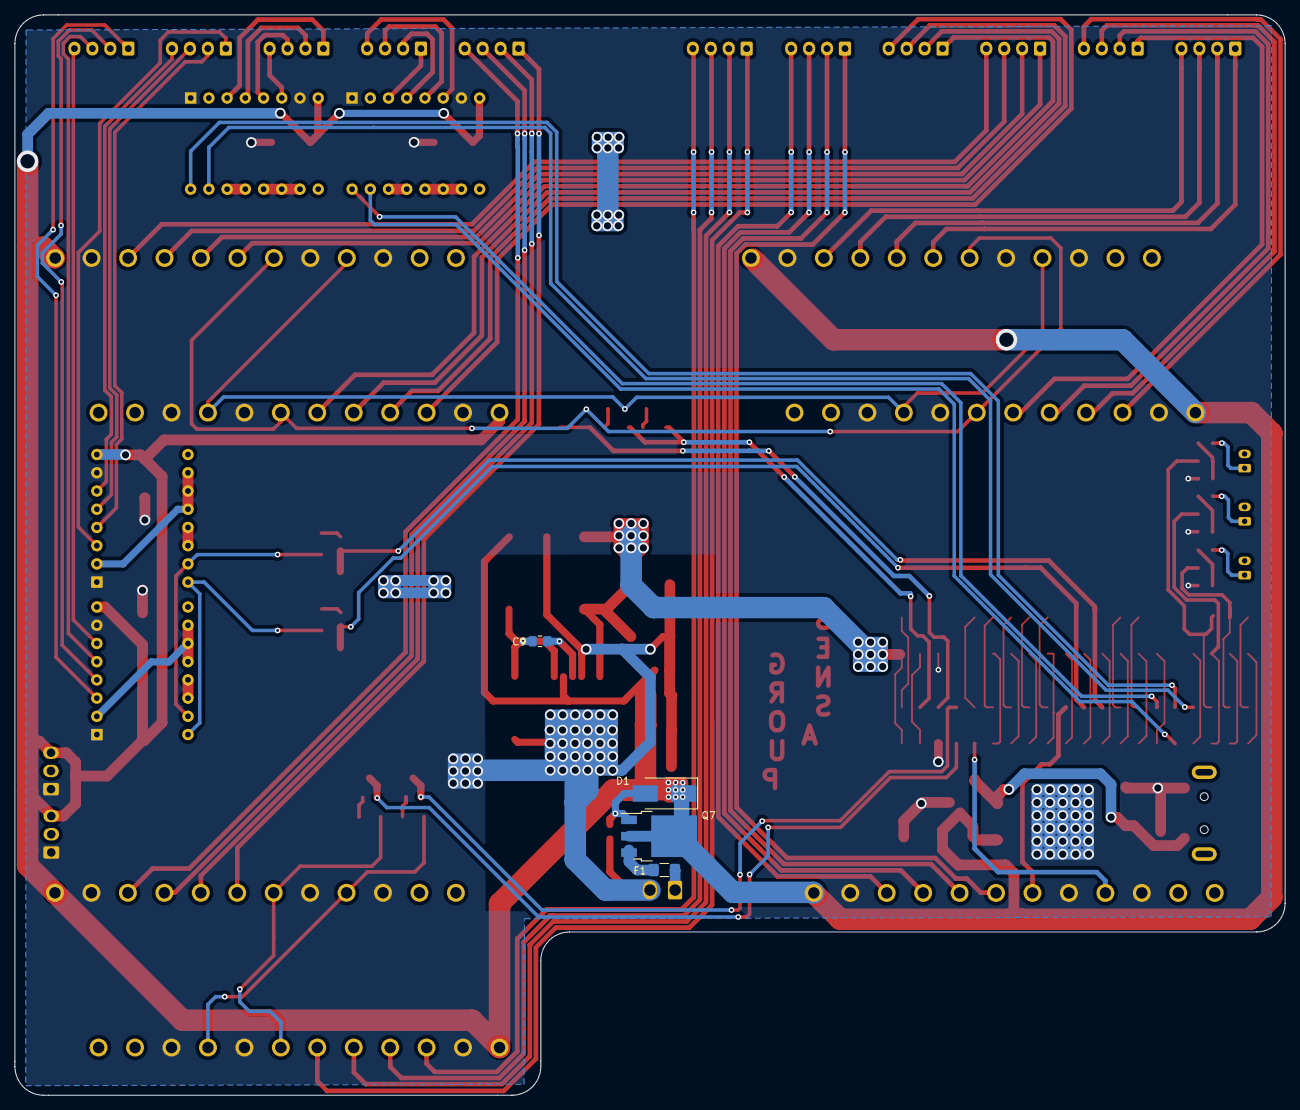
[picture p37: board TonOfSteppers.kicad_pcb from below]

Board: 2 copper layers, 177.1 x 150.6 mm, 85 parts (4 on the bottom side), 113 nets.

Other parts of the board:
DIR1_EN, DIR2_EN, DIR4_EN: TestPoint_Pad_D2.0mm
GND: TestPoint_Pad_D3.0mm
STEP1_EN, STEP2_EN, STEP4_EN: TestPoint_Pad_D2.0mm
V_BUS: TestPoint_Pad_D2.0mm
V_DAT: TestPoint_Pad_D3.0mm
V_MOT: TestPoint_Pad_D3.0mm

Their connections:
/Group 1/DIR1_EN: DIR1_EN.1; also elsewhere on the board
/Group 1/STEP1_EN: STEP1_EN.1; also elsewhere on the board
/Group 2/DIR2_EN: DIR2_EN.1; also elsewhere on the board
/Group 2/STEP2_EN: STEP2_EN.1; also elsewhere on the board
/Group 4/DIR4_EN: DIR4_EN.1; also elsewhere on the board
/Group 4/STEP4_EN: STEP4_EN.1; also elsewhere on the board
GND: GND.1; also elsewhere on the board
V_BUS: V_BUS.1; also elsewhere on the board
V_DAT: V_DAT.1; also elsewhere on the board
V_MOT: V_MOT.1; also elsewhere on the board
