kurdish-yoda/TOS/(commit log)

2021-01-20 Master commit
    Master commit
    [Group1.sch, Group2.sch, Group3.sch, Group3_5_6.sch, Group4.sch, Power.sch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]
2021-04-03 TOS new version
    -Added usb power for display.
    [BOM.xlsx, Power.sch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]
2021-07-25 Sticker Images
    [BOM.xlsx]
2021-08-08 Deleted footprint
2021-12-25 Master code
    Added solenoid functionality utilizing a daughter board.
    [Hc595_Solenoid_Driver-B_Cu.gbl, Hc595_Solenoid_Driver-B_Mask.gbs, Hc595_Solenoid_Driver-B_SilkS.gbo, Hc595_Solenoid_Driver-Edge_Cuts.gm1, Hc595_Solenoid_Driver-F_Cu.gtl, Hc595_Solenoid_Driver-F_Mask.gts, Hc595_Solenoid_Driver-F_SilkS.gto, Hc595_Solenoid_Driver.drl]
